YacineSot/sg13cmos5l_yacinesot_ip__diff_opamp_cmfb/docs/README.md

## document file: 
[View PDF Document](docs/circuit-blocks-documentation.pdf)
