YacineSot/sg13cmos5l_yacinesot_ip__diff_opamp_cmfb/docs/circuit-blocks-documentation.pdf

# 1.5 V Fully Differential Class-AB Operational Amplifier

# Architectural & Subcircuit Documentation

# 1. Architectural Overview & Introduction

Block # | Subcircuit / Module Name | Primary Architectural Role
Block 1 | ota_cmfb_top_tb | Top-Level Multi-Mode SPICE Testbench Schematic
Block 2 | ota_cmfb_top | Top-Level Structural Integration, CMFB Sensing & ESD/Antenna Guarding
Block 3 | ota_cmfb_core | 5-Transistor PMOS Differential Input Core Stage & Output Stage Wrapper
Block 4 | ota_cmfb_core_push_pull_output_stage | Monticelli Class-AB Output Driver with gmp >> gmn Decoupling
Block 5 | ota_cmfb_fbota | Continuous-Time Common-Mode Feedback (CT-CMFB) Error Amplifier
Block 6 | ac_diff_probe | Differential AC Probe for Open-Loop Gain and Phase Measurement
Block 7 | ac_probe | Single-Ended AC Loop-Breaking Probe

# 2. Block 1: Top-Level Testbench (ota_cmfb_top_tb)

# Figure 1: Top-Level Testbench Structured Schematic Diagram (ota_cmfb_top_tb)

Functional Description & Role: Executes all required DC, AC, transient, noise, PSRR, CMRR, and statistical Monte Carlo mismatch simulations for the operational amplifier macro.

# Key Technical Specifications:

- Modular Simulation Control: Toggle individual simulation blocks (OP_SIM, DC_SIM, DC_LOOP_SIM,

# AC_SIM, AC_LOOP_SIM, TRAN_SIM, NOISE_SIM, PSRR_SIM, CMRR_SIM, MC_SIM) on or off and click

SimulateNGSPICE or SimulatePARALLEL to launch.
- Unified Verification Environment: Consolidates nominal corner verification (mos_tt, moscap_tt, res_typ, dio_tt) and 100-run Monte Carlo mismatch analysis (mos_tt_mismatch) within a single testbench interface with default load conditions CL = 0.1 pF and RL = 100 kΩ.

VDD

Vcm
Vinn

Vinp

Ibias

Voutn
Voutp

VSS

EN

NETLIST
VSS VSS 0 0
VDD VDD VDD_AC 1.5
VDD_AC VDD_AC VSS 0 AC 0
VEN EN VSS 1.5
Vcm Vcm VSS {vcm}
Ibias VDD Ibias 2.5u

OP_SIM
.control
op
let ro_n = voutn/i(vmeas2) let ro_p = voutp/i(vmeas3) print ro_n ro_p
write ota_cmfb_top_tb.raw
.endc

Libs_Ngspice

.lib cornerMOSlv.lib mos_tt .lib cornerMOShv.lib mos_tt .lib cornerMOSCAP.lib moscap_tt .lib cornerCAP.lib cap_typ .lib cornerRES.lib res_typ .lib cornerDIO.lib dio_tt

SIM=ngspice

OP annotate

AC_SIM
.control
ac dec 50 100 100G
let vout_diff = voutp-voutn let vin_diff = vinp-vinn
let diff_gain=vout_diff/vin_diff
let op_mag=db(diff_gain)
let op_ph = 180*cph(diff_gain)/pi + 180 let vcm_1 = (voutp+voutn)/2
let vcm_err = mag((vcm_1 - {vcm}))[0]
echo results_save_begin
meas ac dc_gain find op_mag when frequency=1000 meas ac gain_margin find op_mag when op_ph=0
meas ac phase_margin find op_ph when op_mag=0
meas ac bw_3db find frequency when op_mag=dc_gain-3 meas ac Gain_BW find frequency when op_mag=0 print vcm_err
echo results_save_end
plot op_mag op_ph
.endc

PARAMS
.option rshunt=1e9
.options method=gear
.param vcm=0.75 vcm_in=0.75 cl=0.1p vac=1 .save all
Vinp | Voutn
Vinn | Voutp

LOAD
CL1 Voutp 0 {cl}
CL2 Voutn 0 {cl}
RL1 Voutp 0 100k
RL2 Voutn 0 100k

xprobe1
vcm={vcm_in}
vac={vac}
IN | OUT

SAVE
.include ota_cmfb_top_tb.save

Vmeas2 Vmeas3

Vmeas4 Vmeas5

TRAN_SIM
Vinp Vinp 0 sin({vcm_in} 100u 10k) Vinn Vinn 0 sin({vcm_in} -100u 10k) .control
tran 100n 1m
plot Vinp Vinn Voutp Voutn
plot Vinp-Vinn Voutp-Voutn .endc
SimulateNGSPICE

AC_LOOP_SIM
.control
set gain_pcmd = ""
set ph_pcmd = ""
set ph_mrg = ""
set vcm_param = vcm_in
set curplot = new
compose vcm_vec start=0 stop=1.5 step=0.1 foreach vcm_val $&vcm_vec
reset
alterparam $vcm_param =$vcm_val ac dec 50 100 100G
let cur_vcm=$vcm_val
let vout_diff = voutp-voutn
let vin_diff = vinp-vinn
let diff_gain=vout_diff/vin_diff
let op_mag=db(diff_gain)
let op_ph = 180*cph(-diff_gain)/pi
set gain_pcmd = " $gain_pcmd {$curplot}.op_mag " set ph_pcmd = " $ph_pcmd {$curplot}.op_ph "
meas ac phase_margin find op_ph when op_mag=0
if $&phase_margin
set ph_mrg = " $ph_mrg {$curplot}.phase_margin " end
set ph_mrg = " $ph_mrg {$curplot}.cur_vcm "
end
//set nolegend
plot $gain_pcmd
plot $ph_pcmd
print $ph_mrg
.endc

MC_SETTINGS
**nr_workers=1
**nr_mc_sims=100
**results_plot_begin
**dc_gain
**gain_margin
**phase_margin
**bw_3db
**Gain_BW
**vcm_err
**results_plot_end

SimulatePARALLEL

MC_SIM

Vinp Vinp 0 {vcm_in + 100u} Vinn Vinn 0 {vcm_in - 100u} .control
set num_threads 8
op
run
let vcm_err = vcm-vcm_calc
let gain = (voutp-voutn)/(vinp-vinn) echo results_save_begin
print vcm_calc vcm_err gain
echo results_save_end
.endc

SIM=ngspice

Libs_MISMATCH

.lib cornerMOSlv.lib mos_tt_mismatch .lib cornerMOShv.lib mos_tt_mismatch .lib cornerMOSCAP.lib moscap_tt .lib cornerCAP.lib cap_typ
.lib cornerRES.lib res_typ
.lib cornerDIO.lib dio_tt

SIM=ngspice

Vmeas6
Voutp

Vinn

DC_LOOP_SIM
Vt_p Vt_p 0 0
Vt_n Vt_n 0 0
.control
set curplot = new
set plt_voutp = ""
set plt_voutn = ""
set plt_vt_p = ""
set plt_vdiff = ""
set plt_voutpn = ""
compose vcm_vec start=0 stop=1.5 step=0.1 foreach vcm_val $&vcm_vec
alterparam vcm = $vcm_val
reset
dc Vt_p 0 1.5 0.01
let Vout = v(Voutp) - v(Voutn)
set plt_voutp = " {$plt_voutp} {$curplot}.voutp "
set plt_voutn = " {$plt_voutn} {$curplot}.voutn "
set plt_vdiff = " {$plt_vdiff} {$curplot}.vout "
set plt_voutpn = " {$plt_voutpn} {$curplot}.voutp {$curplot}.voutn " end
plot $plt_voutpn
plot $plt_vdiff
.endc

DC_SIM
Vt_p Vt_p 0 0
Vt_n Vt_n 0 0
.control
dc Vt_p 0 1.5 0.01
let Vout = Voutp - Voutn
plot Vt_p Voutp Voutn
plot Vt_p Vout
.endc

2

1 R1

500k
m=1

2

1 R2

500k

m=1

Vmeas7

Voutn

Vinp

2

1 R3

500k

m=1

2

1 R4

500k

m=1

Vt_n Vt_p

Vcm | Vo+ Vo-

XDIFF_AMP1

V+ VDD

V-

Ib

EN

VSS

ota_cmfb_top

NOISE_SIM
Vinp Vinp 0 sin({vcm_in} 100u 10k) Vinn Vinn 0 sin({vcm_in} -100u 10k) .control
tran 100n 1m
plot Vinp Vinn Voutp Voutn
plot Vinp-Vinn Voutp-Voutn .endc

PSRR_SIM
.control
save all
* 1. Measure Differential Gain (Adiff)
* Apply 1V AC across the differential inputs, 0V AC on VDD alterparam vac=1
reset
alter VDD_AC acmag=0
ac dec 10 100 100G
* Store the result in a custom vector let Adiff_db = db(voutp - voutn) alterparam vac=0
reset
* 2. Measure Power Supply Gain (Add)
* Turn off input AC, apply 1V AC on VDD alter VDD_AC acmag=1
ac dec 10 100 100G
* Store the supply gain result
let Add_db = db(voutp - voutn)
* 3. Calculate and Plot True PSRR * PSRR(dB) = Adiff(dB) - Add(dB) let diff_gain = ac1.Adiff_db
let supply_gain = Add_db
let psrr_db = ac1.Adiff_db - Add_db
plot psrr_db ylabel 'PSRR (dB) = A_diff - A_dd' plot supply_gain ylabel 'A_dd (dB)'
plot diff_gain ylabel 'A_diff (dB)'
.endc

CMRR_SIM
.control
save all
ac dec 10 100 100G
let acm_db = db((voutp + voutn)/2) let adiff_db = db(voutp - voutn) let cmrr_db = adiff_db - acm_db
plot acm_db ylabel 'A_CM (dB)'
plot adiff_db ylabel 'A_diff (dB)'
plot cmrr_db ylabel 'CMRR (dB) = A_diff - A_CM' .endc

SPICE SIMULATION

AC ANALYSIS PROBE

CORE OPAMP

MONTE CARLO PYTHON

DC ANALYSIS SINGLE TO DIFF

# 3. Block 2: Top-Level Integration (ota_cmfb_top)

# Figure 2: Top-Level Operational Amplifier Structural Schematic Diagram (ota_cmfb_top)

Functional Description & Role: Integrates the core amplifier (xopamp1), continuous-time CMFB error amplifier (xota1), resistive common-mode sensing divider (R1, R2), layout dummy devices, and global ESD/antenna protection into a single macro pinout.

# Key Technical Specifications & Component Parameters:

- Master Supply Rails: VDD = 1.5 V, VSS = 0.0 V.
- Control & Reference Inputs: Vinp, Vinn, Vcm (output common-mode target range: 0.3 V to 1.1 V), EN (enable), Ibias (2.5 µA reference current).
- Common-Mode Sense Network: Matched resistive divider (R1 = R2, W/L = 0.5 µm / 10.0 µm, m = 1) using the high-resistivity polysilicon resistor model (rhigh) to sense the output common-mode voltage Vcm,calc = (Voutp + Voutn) / 2, sized for optimal matching and low thermal noise.
- Differential Outputs: Voutp, Voutn (1.2 Vpp differential swing).
- Antenna Protection Circuitry: Reverse-biased antenna clamp diodes D1 (dantenna, W = 0.78 µm, L = 0.78 µm) and D2 (dpantenna, W = 1.05 µm, L = 1.34 µm) on the EN net.
- Additional ESD Clamping: Because this circuit is integrated into a multi-project wafer (MPW) where the PDK's analog I/O pads clamp input voltages to Vhigh = 3.3 V and VSS, dedicated secondary ESD clamps (XPCLAMP1–XPCLAMP3, sg13cmos5l_ESD_Protection) are added on Voutp, Voutn, and Vcm to clamp voltages locally to the 1.5 V core supply rail (VDD_BUS).
Vcm | Vo+ Vo-

## xopamp1

## V+ VDD

V-

Ib

EN

## VSS

## ota_cmfb_core

Vb

# VDD

# Vcm_reg Vinn

# Vinp

# Ibias

# Voutn Voutp

# VSS

EN

# Vcm

# Vcm_calc

## xota1

## V+ VDD

V-

Ib

EN

## VSS

## ota_cmfb_fbota

# VDD

EN

# Vbias

# VSS

# Vcm_reg

Voutp | Voutn
M7

G

## sg13_lv_nmos

m=2

ng=1

l=0.5u

w=0.25u

S

D
B

?

# VSS

## w/l = 0.5e-6 / 1e-6*10

## rhigh

R1

R= ( 1.6e-4 / 0.5e-6 + 1360.0 * ( (0 + 1)* 1e-6*10 + ( 1.081*( 0.5e-6 - 0.04e-6 ) + 0.18e-6 )*0 ) / ( 0.5e-6 - 0.04e-6 ) ) / 1

b=0
m=1

## w/l = 0.5e-6 / 1e-6*10 VSS

## rhigh

R2

b=0
m=1

VSS
M1

G

## sg13_lv_nmos

m=10

ng=1

l=0.5u

w=3.2u

S

D
B

?

# VSS

M2

G

## sg13_lv_pmos

m=100

ng=1

l=0.5u

w=1.985u

D

S
B
?

# VDD

D1

## dantenna

d0

d1
l=0.78u
w=0.78u

D2

## dpantenna

d0

d1
l=1.34u
w=1.05u

# VDD

# VSS

# Vbias

# Vbias

pad

VDD

SUB

XPCLAMP1 sg13cmos5l_ESD_Protection

pad

VDD

SUB

XPCLAMP2 sg13cmos5l_ESD_Protection

pad

VDD

SUB

XPCLAMP3 | sg13cmos5l_ESD_Protection
VSS | VSS

# VSS

VDD_BUS | VDD_BUS

# VDD_BUS

| s1 .include /run/media/yacinesot/My_Files/XschemDesigns/designs/Chipalooza2/schema/sg13cmos5l_ESD_Protection/sg13cmos5l_ESD_Protection.spice
FEEDBACK LOOP R= ( 1.6e-4 / 0.5e-6 + 1360.0 * ( (0 + 1)* 1e-6*10 + ( 1.081*( 0.5e-6 - 0.04e-6 ) + 0.18e-6 )*0 ) / ( 0.5e-6 - 0.04e-6 ) ) / 1 | XCLAMP_LVS_NETLIST Dummies EN
Voutp | Voutn

# Vcm

s2

# VDD_BUS VDD_BUS 0 1.5

# CORE OPAMP

# 4. Block 3: Differential Input Core Stage (ota_cmfb_core)

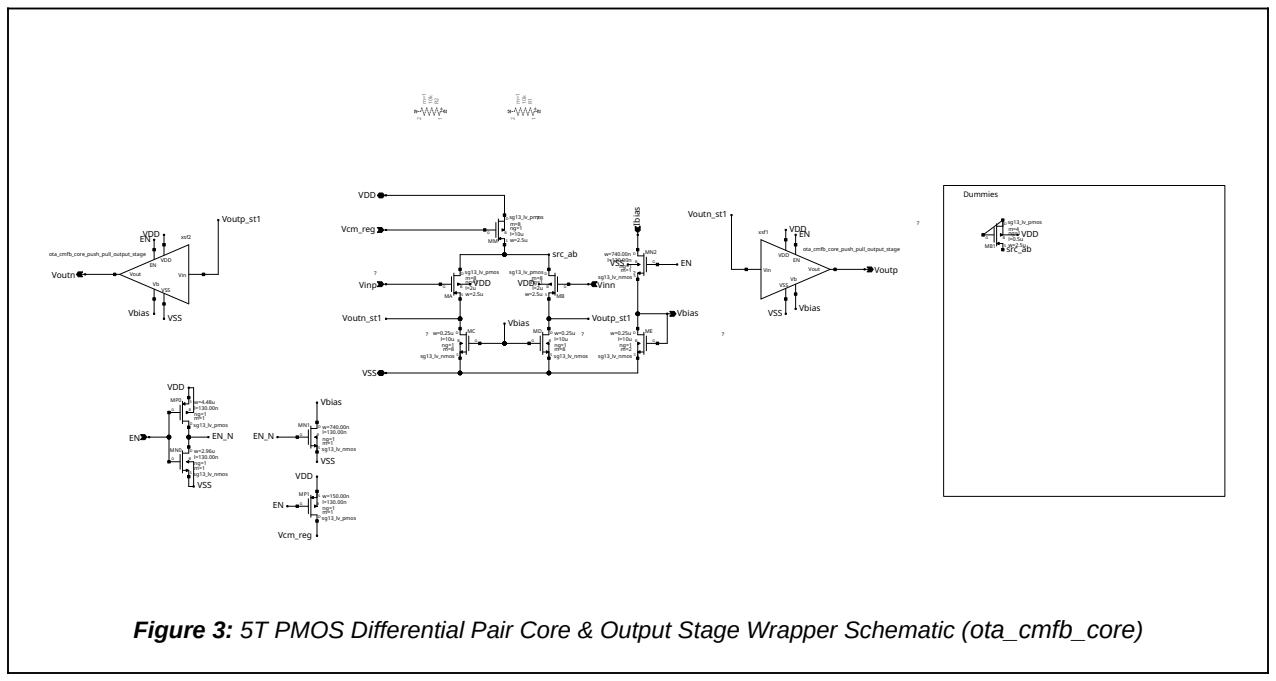
[picture p5: figure]
sg13_lv_nmos; sg13_lv_pmos m=8 ng=1 l=2u w=2.5u; sg13_lv_pmos m=8 ng=1 l=10u w=2.5u; Voutn; Voutp; VDD; VSS; Vinp; Ibias; Vinn; Vcm_reg; Vbias; Voutp_st1; VSS Vbias; Voutn_st1; Vout; xsf1; Vin; ota_cmfb_core_push_pull_output_stage; xsf2; sg13_lv_pmos; sg13_lv_pmos m=4 ng=1 l=0.5u w=2.5u; src_ab src_ab; B VSS; Dummies

# Figure 3: 5T PMOS Differential Pair Core & Output Stage Wrapper Schematic (ota_cmfb_core)

Functional Description & Role: Provides primary input transconductance (gm1) and first-stage voltage gain (Av1) with ultra-low flicker (1/f) noise, driving the dual Class-AB push-pull output stage instances (xsf1, xsf2).

# Key Technical Specifications & Transistor Parameters:

- Input Drivers (MA / MB): PMOS differential pair (sg13_lv_pmos) sized W/L = 2.5 µm / 2.0 µm (m = 8) to suppress 1/f flicker noise and maximize intrinsic device gain (gm · rout).
- Active Loads (MC / MD): Long-channel NMOS active loads (sg13_lv_nmos, W/L = 0.25 µm / 10.0 µm, m = 8) biased via diode-connected reference transistor ME (W/L = 0.25 µm / 10.0 µm, m = 2) to provide high first-stage output impedance.
- Tail Bias Generator (MM): PMOS current source (sg13_lv_pmos, W/L = 2.5 µm / 10.0 µm, m = 8) controlled directly by the CMFB error signal (Vcm_reg).
- First-Stage Output Nodes: Voutn_st1 and Voutp_st1 driving the push-pull output stage instances (xsf1, xsf2).

# 5. Block 4: Monticelli Class-AB Output Stage

# (ota_cmfb_core_push_pull_output_stage)

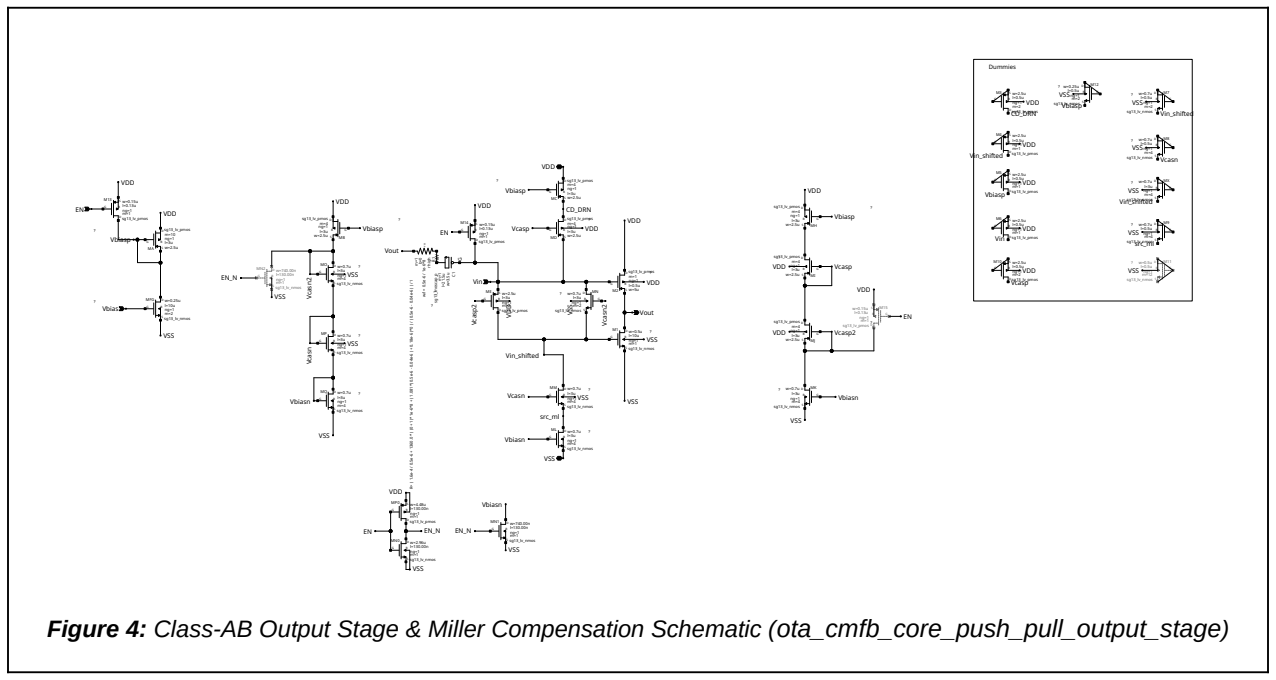
[picture p6: figure]
sg13_lv_nmos; sg13_lv_pmos m=1 ng=1 l=0.5u w=5u; VDD; VSS; Vbias; Vin; Vout; Vin_shifted; sg13_lv_pmos m=4 ng=1 l=3u w=2.5u; Vbiasn; Vbiasp; Vcasn2; Vcasp2; sg13_lv_pmos; Vcasp; Vcasn; rhigh; sg13_moscap_p; MFG; sg13_lv_pmos m=10 ng=1 l=3u w=2.5u; CD_DRN; ? VSS; ? VSS Vin_shifted; src_ml; ? VSS src_ml; VDD Vcasp; ? VSS Vbiasp; Dummies

Figure 4: Class-AB Output Stage & Miller Compensation Schematic (ota_cmfb_core_push_pull_output_stage)

Functional Description & Role: A fully self-contained, cascoded Monticelli Class-AB push-pull output buffer providing dynamic current drive, wide rail-to-rail output swing (0.1V to 1.3 V), and second-stage voltage gain. The block integrates its own internal cascode and translinear mesh bias generators derived directly from the 2.5 μ A master reference (Vbias), along with dedicated active-high enable (EN) tie-off switches on every floating bias and signal node.

# Key Technical Specifications & Transistor Parameters:

# - Primary Reference Mirror (MFG / MA): MFG (sg13_lv_nmos, W / L=0.25 μm / 10.0 μm, m=2

) is unit-matched to the first-stage bias reference (ME) to accurately copy the 2.5 μ A reference current, driving diode-connected PMOS load MA (sg13_lv_pmos, W / L=2.5 μm / 3.0 μm, m=10) to establish the master PMOS bias rail (Vbiasp).

- Cascoded Current-Source Loads (MC, MD & ML, MM): In textbook Monticelli topologies, the floating Class-AB control mesh is biased by ideal current sources; here, high-impedance cascoded current sources are implemented via MC (main PMOS current source) cascoded by MD (both W / L=2.5 μm / 3.0 μm, m= 4) on the upper branch, and ML (main NMOS current

source) cascoded by MM (both W / L=0.7 μm / 3.0 μm, m= 4) on the lower branch.
- Floating Class-AB Mesh / Level Shifters (ME & MN): Head-to-tail translinear mesh transistors ME (sg13_lv_pmos, W / L=2.5 μm / 3.0 μm, m=2, biased by Vcasp2) and MN (sg13_lv_nmos, W / L=0.7 μm / 3.0 μm, m=2, biased by Vcasn2) act as floating voltage level shifters between

# the Vin (PMOS gate) and Vin_shifted (NMOS gate) nodes, regulating quiescent Class-AB

current while providing dynamic push-pull drive.

# - Integrated Cascode & Mesh Bias Generators: Two multi-device replica stacks generate all required cascode and mesh bias potentials locally:PMOS Bias Branch (MH, MI, MJ —

R= ( 1.6e-4 / 0.5e-6 + 1360.0 * ( (0 + 1)* 1e-6*8 + ( 1.081*( 0.5e-6 - 0.04e-6 ) + 0.18e-6 )*0 ) / ( 0.5e-6 - 0.04e-6 ) ) / 1

# W / L=2.5 μm / 3.0 μm, m= 4): Establishes Vcasp and Vcasp2, terminated at the bottom by

NMOS diode load MK (W / L=0.7 μm / 3.0 μm, m= 4) to generate Vbiasn.

# - NMOS Bias Branch (MB, MO, MP, MQ): Mirrors the PMOS current via MB (

W / L=2.5 μm / 3.0 μm, m= 4) into the NMOS stack (MO, MP, MQ — W / L=0.7 μm / 3.0 μm,

# m= 4) to generate Vcasn2 and Vcasn. Pairing MK and MQ with MH and MC enforces strict

current matching across all branches.

# - Asymmetric Output Drivers (M2 & M1) & Pole-Zero Positioning: PMOS driver M2 (

W / L=5.0 μm / 0.5 μm, m=1) and long-channel NMOS driver M1 (W / L=0.5 μm / 10.0 μm,

# m=1) establish gmp≫gmn asymmetry, pushing the NMOS right-half-plane (RHP) zero well

above the target unity-gain bandwidth (GBW = 40 – 50MHz).
- Miller Compensation Network (C1 & R1): PMOS accumulation capacitor CC (C1,

# sg13_moscap_p, W =3.5 μm , L=21.5 μm ,m=1) in series with nulling resistor RC =23.97 k Ω

(R1, rhigh, W / L=0.5 μm / 8.0 μm ,m=1) guarantees a 60 – 65 phase margin.

# - Full Floating-Node Enable / Power-Down Protection: An active-high enable (EN) inverter (MP0 / MN0) generates EN_N to drive dedicated pull-up (M13, M14, M15 to VDD) and pull-

down (MN1, MN2 to VSS) switches on every internal bias and floating node (Vbiasp, Vbiasn, Vcasp2, Vcasn2, Vin), eliminating floating-gate leakage and ensuring deterministic zero-current shutdown when EN = 0.

# 6. Block 5: Continuous-Time CMFB Amplifier (ota_cmfb_fbota)

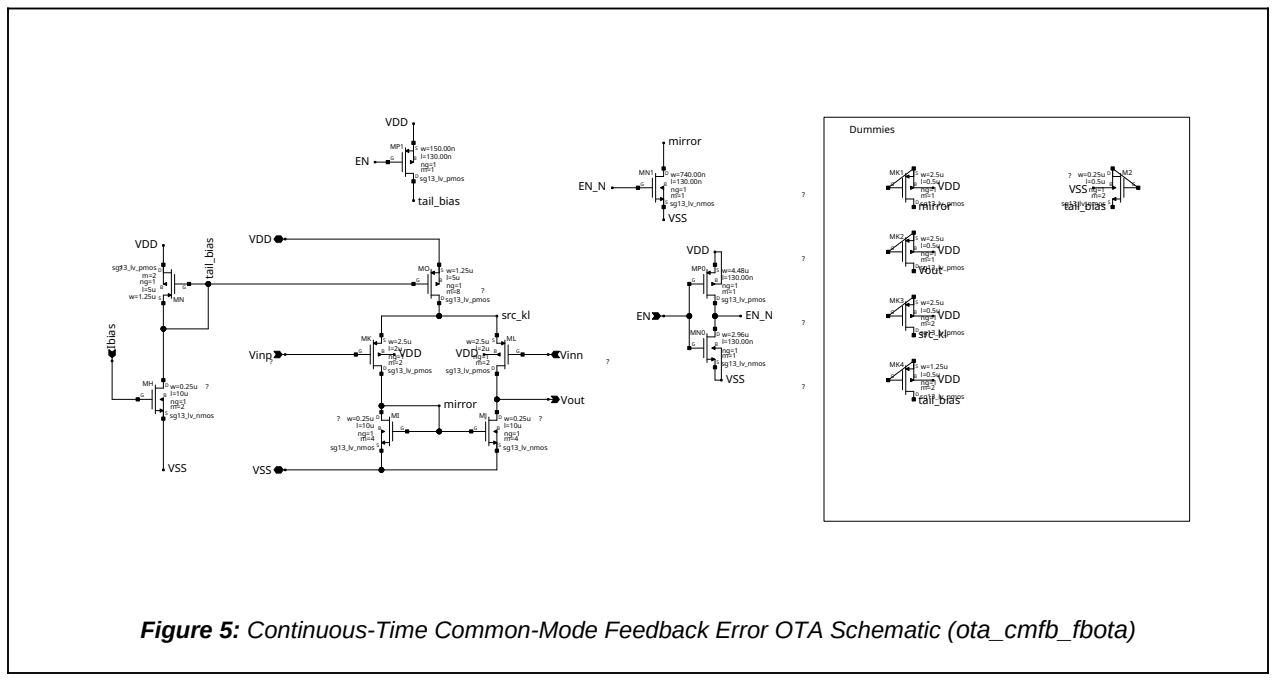
[picture p7: figure]
sg13_lv_nmos; sg13_lv_pmos; Vout; VDD; VSS; Vinp; Ibias; Vinn; mirror; sg13_lv_pmos m=2 ng=1 l=5u w=1.25u; tail_bias; ? VSS tail_bias; VDD mirror; VDD Vout; src_kl; VDD src_kl; VDD tail_bias; Dummies

# Figure 5: Continuous-Time Common-Mode Feedback Error OTA Schematic (ota_cmfb_fbota)

Functional Description & Role: Senses the output common-mode voltage error and regulates the main core tail bias (Vcm_reg) to lock Vcm,out at the user's reference input Vcm.

# Key Technical Specifications & Transistor Parameters:

- Error Input Pair (MK / ML): PMOS differential input pair (sg13_lv_pmos, W/L = 2.5 µm / 2.0 µm, m = 2) comparing the sensed common-mode voltage (Vcm_calc) against the Vcm reference.
- Active Mirror Load (MI / MJ): Long-channel NMOS current mirror load (sg13_lv_nmos, W/L = 0.25 µm / 10.0 µm, m = 4) providing the single-ended regulation output Vout (Vcm_reg).
- Tail Current Mirror (MO / MN / MH): PMOS tail current source MO (W/L = 1.25 µm / 5.0 µm, m = 8) mirrored from diode-connected MN (m = 2) and reference sink MH (W/L = 0.25 µm / 10.0 µm, m = 2).

# - Low-Frequency Common-Mode Rejection: Provides >97.5 dB CMRR at low frequencies under

statistical Monte Carlo mismatch.

# 7. Block 6: Differential AC Probe (ac_diff_probe)

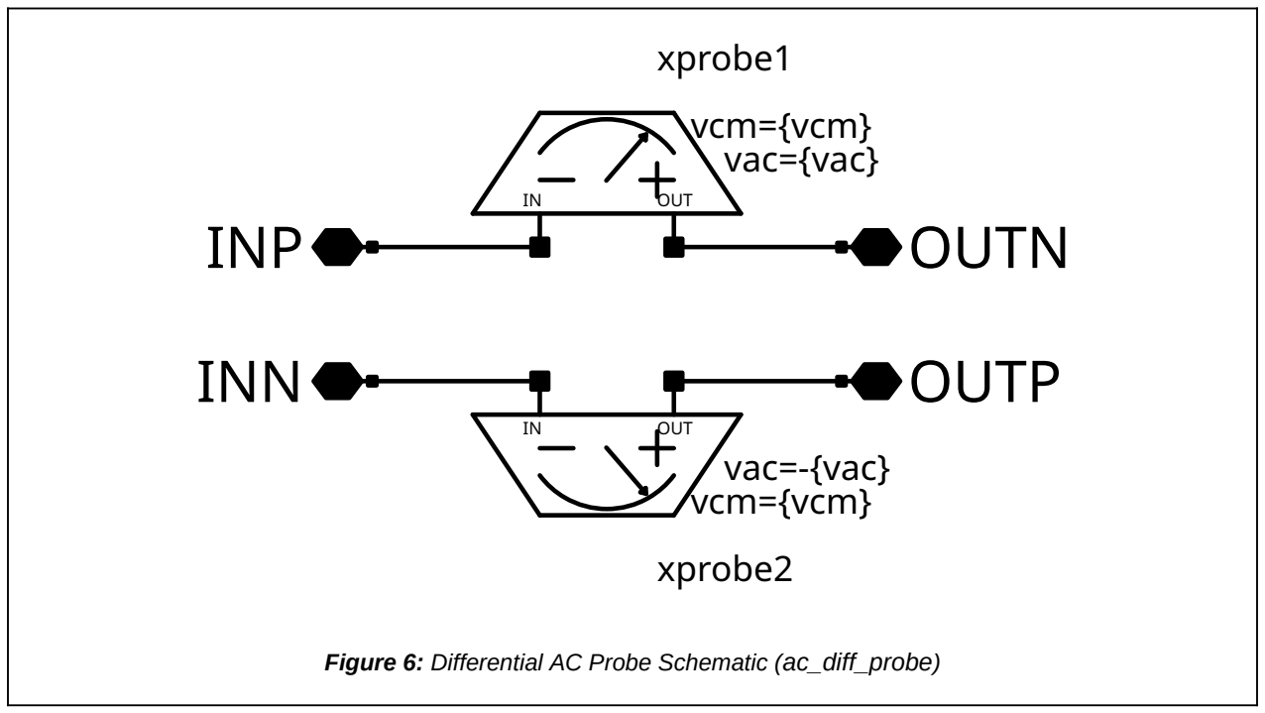
[picture p8: figure]
xprobe1 vcm={vcm} vac={vac}; OUT; xprobe2; vcm={vcm}; vac=-{vac}; INP; OUTN; INN; OUTP

# Figure 6: Differential AC Probe Schematic (ac_diff_probe)

Functional Description & Role: Closes the operational amplifier feedback loop at DC while blocking AC feedback and injecting a differential AC stimulus to measure open-loop gain and phase in a fully differential topology.

# Key Technical Specifications:

- Dual Single-Ended Probe Topology: Instantiates two matched single-ended AC probes (xprobe1 driven with vcm={vcm}, vac={vac} between INP and OUTN; xprobe2 driven with anti-phase vcm={vcm}, vac=-{vac} between INN and OUTP).

# 8. Block 7: Single-Ended AC Probe (ac_probe)

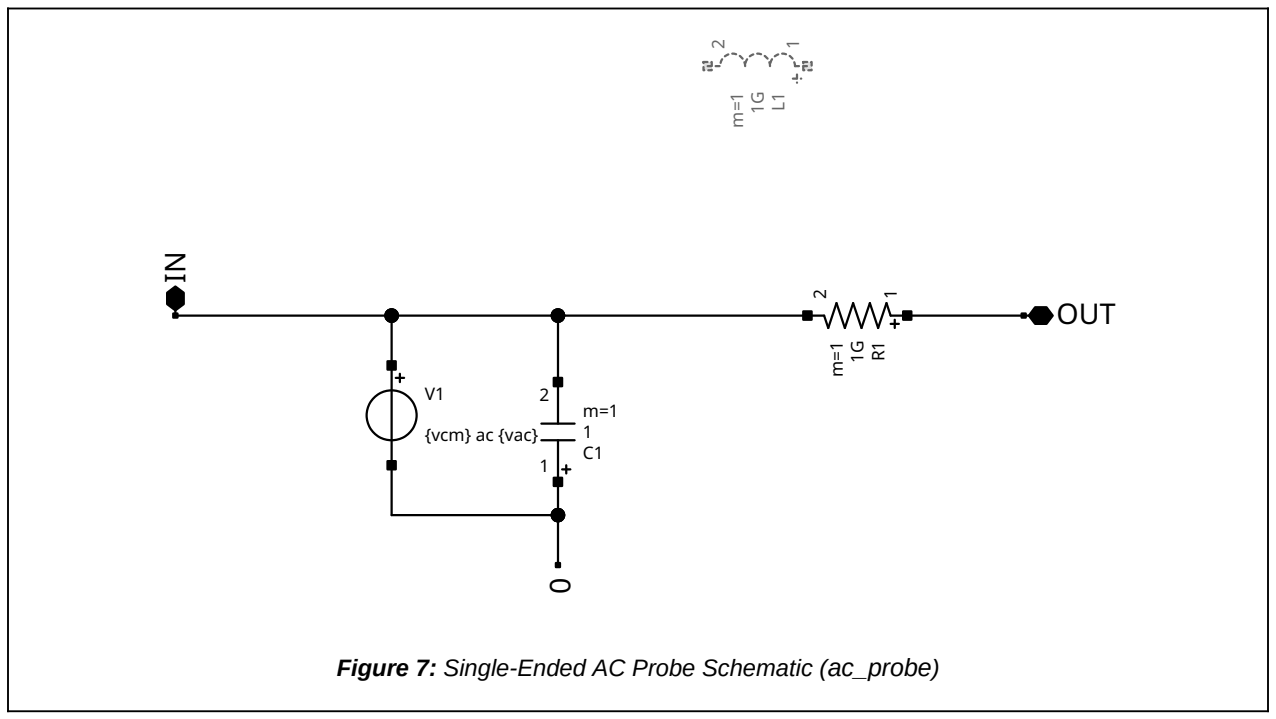
[picture p9: figure]
OUT; {vcm} ac {vac}

# Figure 7: Single-Ended AC Probe Schematic (ac_probe)

Functional Description & Role: Used as the core building block inside the differential AC probe (ac_diff_probe), and can also be used standalone in single-ended amplifier topologies to sense open-loop AC gain while maintaining DC operating-point feedback.

# Key Technical Specifications & Component Parameters:

- Large-RC Loop-Breaking Network: Combines a 1 GΩ feedback resistor (R1 = 1G, m = 1) between OUT and IN with a 1 F AC-shunt capacitor (C1 = 1, m = 1) and parameterized AC/DC voltage source V1 ({vcm} ac {vac}) to pass DC feedback while isolating the AC test signal.
