YacineSot/sg13cmos5l_yacinesot_ip__diff_opamp_cmfb/docs/schema.png

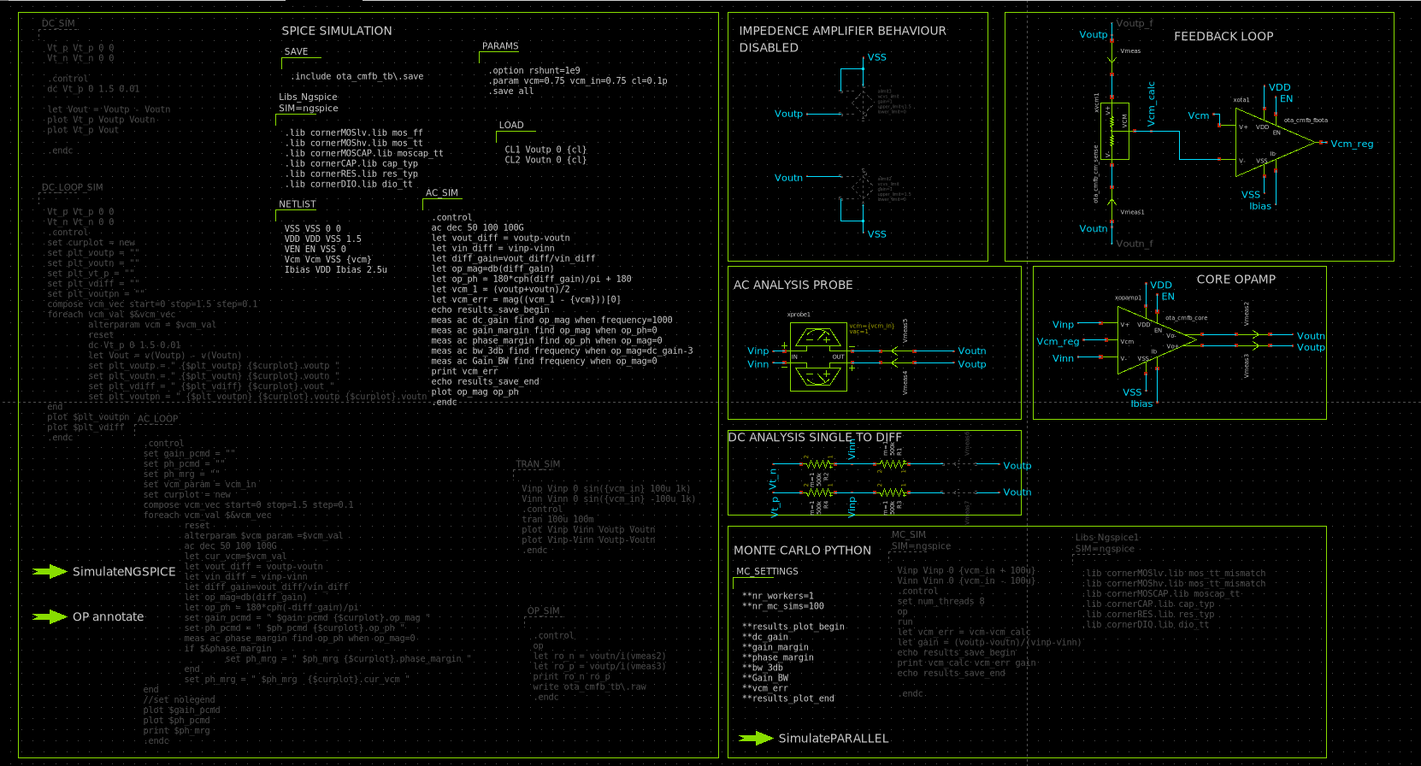
docs/schema.png
