YacineSot/sg13cmos5l_yacinesot_ip__diff_opamp_cmfb/schema/simulations/results/ota_cmfb_tb_mc_results.csv

dc_gain | gain_margin | phase_margin | bw_3db | gain_bw | vcm_err
47.1455 | -9.57211 | 61.4999 | 207017.0 | 51228600.0 | 0.002523438
44.8229 | -9.9307 | 64.5569 | 245086.0 | 48682000.0 | 0.01520574
46.3421 | -9.63473 | 61.8204 | 228009.0 | 51891500.0 | 0.01174944
44.6482 | -9.93246 | 64.7202 | 248711.0 | 48639400.0 | 0.01637787
45.2216 | -9.91678 | 64.055 | 237415.0 | 48814900.0 | 0.0139052
45.6358 | -9.85549 | 63.5306 | 231183.0 | 49072000.0 | 0.01107272
41.9859 | -10.4175 | 67.1973 | 297154.0 | 44809200.0 | 0.02031546
32.7754 | -11.1453 | 72.3986 | 599553.0 | 38848300.0 | 0.0267547
46.7651 | -9.63541 | 61.4848 | 215913.0 | 51095900.0 | 0.005474977
39.1572 | -10.6207 | 69.1689 | 368317.0 | 42753600.0 | 0.0227545
45.1221 | -9.88121 | 64.1517 | 238595.0 | 49022900.0 | 0.01398859
36.5019 | -10.8788 | 70.6845 | 449631.0 | 40771200.0 | 0.02492743
44.4751 | -10.0176 | 64.7135 | 252207.0 | 48106500.0 | 0.0158984
42.4171 | -10.3309 | 66.7388 | 291018.0 | 45870500.0 | 0.02128149
43.2979 | -10.2406 | 66.5331 | 264097.0 | 45690400.0 | 0.01660877
46.822 | -9.54805 | 61.7542 | 215506.0 | 51840100.0 | 0.006786055
38.7217 | -10.7533 | 69.6028 | 376020.0 | 41921500.0 | 0.0237199
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
