YacineSot/sg13cmos5l_yacinesot_ip__diff_opamp_cmfb/schema/simulations/results/ota_cmfb_top_pex_tb_mc_cmrr.csv

cmrr_100 | cmrr_ugf
81.7914 | 9.10245
118.557 | 41.8834
99.7083 | 23.2925
108.935 | 27.7405
100.209 | 22.5916
84.0874 | 10.7756
107.458 | 26.2868
91.2335 | 15.2166
114.246 | 36.1042
78.0669 | 8.22965
111.632 | 39.9823
92.9463 | 16.6244
96.6593 | 18.3554
103.222 | 20.8659
91.3873 | 14.898
81.0615 | 9.07857
108.548 | 32.0787
97.4844 | 20.8995
106.529 | 26.9544
88.9524 | 12.5535
116.95 | 42.4238
95.422 | 18.1458
101.889 | 20.8874
110.735 | 34.7259
87.0277 | 11.8912
117.549 | 41.6751
85.1861 | 10.3839
80.7102 | 8.80754
102.573 | 24.9306
113.291 | 34.5285
94.5806 | 17.0903
99.8839 | 20.523
91.9975 | 16.8292
98.9371 | 19.4028
109.386 | 26.2715
91.4747 | 14.9583
96.3318 | 18.9537
86.0406 | 11.2674
94.1537 | 17.8168
90.1518 | 13.5032
95.8139 | 19.5823
95.8508 | 18.1555
93.7551 | 16.0331
94.7409 | 17.8068
99.6166 | 21.642
92.3017 | 15.2425
89.433 | 13.3446
87.5392 | 11.6693
97.6259 | 19.7249
89.256 | 13.1899
94.128 | 15.9575
91.0874 | 13.9212
80.9604 | 8.75672
89.1402 | 13.7353
100.015 | 21.8852
86.6697 | 12.0925
82.4525 | 9.9779
98.5801 | 20.1779
92.7148 | 15.2764
93.3225 | 16.4813
96.9347 | 20.1372
97.9545 | 20.3021
117.853 | 43.004
90.7896 | 14.098
89.5209 | 13.3286
86.1333 | 11.391
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
