YacineSot/sg13cmos5l_yacinesot_ip__diff_opamp_cmfb/schema/simulations/results/ota_cmfb_top_pex_tb_mc_noise.csv

noise_1 | noise_10 | noise_100 | noise_1k | noise_10k | noise_100k | noise_1meg | inoise_total
6.37764e-06 | 2.016932e-06 | 6.382673e-07 | 2.03279e-07 | 6.868025e-08 | 3.293664e-08 | 2.869544e-08 | 1.952248e-05
6.373428e-06 | 2.015601e-06 | 6.378513e-07 | 2.031618e-07 | 6.868583e-08 | 3.307218e-08 | 2.892062e-08 | 1.95113e-05
6.397274e-06 | 2.023143e-06 | 6.40239e-07 | 2.039264e-07 | 6.895496e-08 | 3.311808e-08 | 2.877224e-08 | 1.958481e-05
6.410063e-06 | 2.027188e-06 | 6.415179e-07 | 2.043284e-07 | 6.907498e-08 | 3.316583e-08 | 2.889141e-08 | 1.962317e-05
6.406275e-06 | 2.02599e-06 | 6.41141e-07 | 2.042157e-07 | 6.905842e-08 | 3.318764e-08 | 2.882713e-08 | 1.961247e-05
6.408208e-06 | 2.026602e-06 | 6.413367e-07 | 2.042856e-07 | 6.910382e-08 | 3.322351e-08 | 2.88464e-08 | 1.961936e-05
6.41498e-06 | 2.028743e-06 | 6.4201e-07 | 2.044861e-07 | 6.913119e-08 | 3.319481e-08 | 2.88613e-08 | 1.963837e-05
6.418417e-06 | 2.029829e-06 | 6.423524e-07 | 2.045915e-07 | 6.915595e-08 | 3.315436e-08 | 2.876297e-08 | 1.964852e-05
6.37641e-06 | 2.016543e-06 | 6.381468e-07 | 2.03248e-07 | 6.869072e-08 | 3.294669e-08 | 2.859339e-08 | 1.951955e-05
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
