YacineSot/sg13cmos5l_yacinesot_ip__diff_opamp_cmfb/schema/simulations/results/ota_cmfb_top_pex_tb_mc_psrr.csv

psrr_100 | psrr_ugf
58.1249 | 14.7883
57.1335 | 13.3678
59.8133 | 18.4378
60.1627 | 16.7432
76.0866 | 28.8242
56.7827 | 12.2603
53.5812 | 10.6886
61.6259 | 16.7517
55.8288 | 13.5611
59.2358 | 15.7044
88.7618 | 35.1159
79.4503 | 35.9983
45.7652 | 7.39977
57.0305 | 18.1458
59.298 | 15.6044
72.1934 | 31.3225
58.996 | 24.887
55.1895 | 21.0139
55.6049 | 14.136
59.0175 | 14.9096
51.4366 | 10.9887
64.2497 | 21.3751
54.7188 | 11.2002
53.9948 | 10.3968
73.1389 | 27.4356
51.7979 | 10.9114
54.9503 | 10.6112
58.6731 | 16.1973
68.196 | 25.0019
61.9792 | 18.9896
63.7994 | 20.9468
48.4644 | 5.8941
53.7845 | 13.4578
54.1425 | 16.3073
53.2388 | 9.11531
58.8 | 16.0313
57.3463 | 17.1784
58.1244 | 13.796
54.0794 | 14.5264
69.5491 | 32.4788
77.5079 | 28.3036
55.8905 | 11.3108
55.9033 | 14.2218
61.2443 | 17.0912
46.6683 | 4.18193
57.5559 | 14.1437
70.2096 | 25.6923
51.475 | 5.96283
65.2174 | 21.6038
71.559 | 30.0737
53.8099 | 10.1562
61.205 | 19.9796
56.2822 | 12.4094
54.931 | 10.8354
59.4964 | 16.2495
56.226 | 17.8955
53.0407 | 7.83529
59.0775 | 16.3715
58.0854 | 16.8229
111.507 | 33.0247
58.0163 | 13.9324
60.813 | 17.18
56.798 | 15.8397
76.7819 | 40.5926
52.0816 | 6.70482
56.1026 | 14.7014
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
