YacineSot/sg13cmos5l_yacinesot_ip__diff_opamp_cmfb/schema/simulations/results/ota_cmfb_top_pex_tb_mc_results.csv

dc_gain | gain_margin | phase_margin | bw_3db | gain_bw | vcm_err
42.9257 | -7.7131 | 63.9481 | 249767.0 | 51909700.0 | 0.0165479
39.0585 | -7.76349 | 69.8738 | 349551.0 | 47251800.0 | 0.02053602
45.4611 | -6.85255 | 60.7831 | 199241.0 | 57362400.0 | 0.01087507
45.8623 | -7.40677 | 58.0737 | 196661.0 | 56767100.0 | 0.01018161
44.0155 | -7.62785 | 60.8849 | 231047.0 | 54769200.0 | 0.01566812
45.4801 | -6.91623 | 58.2316 | 202026.0 | 58964000.0 | 0.01159245
46.0408 | -7.04303 | 58.6688 | 192908.0 | 57819700.0 | 0.009289289
47.1319 | -6.65843 | 54.618 | 177252.0 | 62359500.0 | 0.005355808
47.3224 | -6.59543 | 55.0972 | 174038.0 | 62553500.0 | 0.003487363
46.6163 | -6.29118 | 54.8793 | 177668.0 | 65234500.0 | 0.009659106
46.6996 | -6.88999 | 55.799 | 183123.0 | 60195700.0 | 0.00696311
47.0481 | -7.09716 | 54.9807 | 180577.0 | 60373000.0 | 0.005957765
46.3429 | -6.7742 | 57.7843 | 188291.0 | 60059200.0 | 0.008454872
46.6349 | -6.77502 | 55.7509 | 184018.0 | 60935500.0 | 0.007291531
46.7444 | -7.00001 | 55.9483 | 186237.0 | 60382700.0 | 0.007660375
47.0701 | -6.48472 | 54.0023 | 179864.0 | 64219400.0 | 0.006039867
37.8002 | -8.61984 | 68.317 | 381556.0 | 44662100.0 | 0.02014335
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
