YacineSot/sg13cmos5l_yacinesot_ip__diff_opamp_cmfb/schema/simulations/results/ota_cmfb_top_tb_mc_results.csv

dc_gain | gain_margin | phase_margin | bw_3db | gain_bw | vcm_err
46.6201 | -4.75065 | 63.1752 | 216082.0 | 78864300.0 | 0.003282814
45.234 | -5.54867 | 64.3924 | 246107.0 | 72550100.0 | 0.01082155
45.6384 | -5.03631 | 64.9312 | 237689.0 | 75420600.0 | 0.009506908
46.6568 | -5.03296 | 63.0327 | 213107.0 | 77007600.0 | 0.003012813
41.0084 | -5.95927 | 73.5021 | 337318.0 | 57353500.0 | 0.01592211
29.0823 | -6.9297 | 81.5251 | 894176.0 | 40948500.0 | 0.02041766
30.3815 | -6.68028 | 81.1918 | 807097.0 | 41674200.0 | 0.01976359
45.1921 | -5.51568 | 65.6993 | 242025.0 | 70756400.0 | 0.01014312
28.2989 | -6.07123 | 84.807 | 942923.0 | 40587200.0 | 0.02232775
40.4082 | -6.25882 | 72.7368 | 357746.0 | 56916400.0 | 0.01839029
45.6581 | -4.92743 | 65.4883 | 234844.0 | 74993600.0 | 0.008958449
31.595 | -6.82094 | 80.0701 | 727853.0 | 42944800.0 | 0.02085175
46.2082 | -4.64309 | 63.8481 | 226026.0 | 79418000.0 | 0.006173965
46.3917 | -5.11821 | 62.713 | 221719.0 | 77150500.0 | 0.00534376
34.5163 | -7.23386 | 76.5467 | 582588.0 | 47290000.0 | 0.0197615
39.6885 | -6.56908 | 73.2133 | 373427.0 | 54391900.0 | 0.01853998
31.8339 | -5.83735 | 83.21 | 721540.0 | 43879000.0 | 0.02002658
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
