YacineSot/sg13cmos5l_yacinesot_ip__diff_opamp_cmfb/schema/sg13cmos5l_ESD_Protection/sg13cmos5l_ESD_Protection.spice

*.PININFO iovdd:B iovss:B pad:B
.subckt sg13cmos5l_ESD_Protection iovdd iovss pad
XI0 iovdd iovss pad sg13cmos5l_Clamp_P20N0D
XI2 pad iovdd iovss sg13cmos5l_DCPDiode
.ends

.subckt sg13cmos5l_Clamp_P20N0D iovdd iovss pad
XMP1 pad net2 iovdd iovdd sg13_hv_pmos w=133.2u l=600.0n ng=20 ad=2.531e-11 as=2.731e-11 pd=0.0001408 ps=0.0001547 m=1
XMP0 pad net2 iovdd iovdd sg13_hv_pmos w=133.2u l=600.0n ng=20 ad=2.531e-11 as=2.731e-11 pd=0.0001408 ps=0.0001547 m=1
XR0 net2 iovdd iovdd rppd R=6.768K l=12.9u w=500n
XR1 iovss sub! ptap1 R=9.826
.ends

.subckt sg13cmos5l_DCPDiode anode cathode guard
XD1 anode cathode dpantenna l=27.78u w=1.26u m=1
XD0 anode cathode dpantenna l=27.78u w=1.26u m=1
XR0 guard sub! ptap1 R=17.289
.ends
