YacineSot/sg13cmos5l_yacinesot_ip__diff_opamp_cmfb/schema/simulations/ota_cmfb_top.spice

** sch_path: /run/media/yacinesot/My_Files/XschemDesigns/designs/Chipalooza2/schema/ota_cmfb_top.sch
.subckt slot_5 Vcm VDD EN Vinp Voutn Voutp Vinn VSS Ibias
*.PININFO VDD:B Vinn:I Vinp:I Ibias:I Voutn:O Voutp:O VSS:B EN:I Vcm:I
xopamp1 VDD Vcm_reg Vinn Vinp Ibias Voutn Voutp VSS EN Vbias ota_cmfb_core
xota1 VDD EN Vbias Vcm_calc Vcm Vcm_reg VSS ota_cmfb_fbota
MM7 VSS VSS Vbias VSS sg13_lv_nmos w=0.25u l=0.5u ng=1 m=2
RR1 Voutn Vcm_calc 29.89k $SUB=VSS $[rhigh] w=0.5e-6 l=1e-6*10 b=0
RR2 Voutp Vcm_calc 29.89k $SUB=VSS $[rhigh] w=0.5e-6 l=1e-6*10 b=0
MM1 VSS VSS VSS VSS sg13_lv_nmos w=3.2u l=0.5u ng=1 m=10
MM2 VDD VDD VDD VDD sg13_lv_pmos w=1.985u l=0.5u ng=1 m=100
DD1 VSS EN dantenna l=0.78u w=0.78u
DD2 EN VDD dpantenna l=1.34u w=1.05u
XPCLAMP1 VDD_BUS VSS Voutp sg13cmos5l_ESD_Protection
XPCLAMP2 VDD_BUS VSS Voutn sg13cmos5l_ESD_Protection
XPCLAMP3 VDD_BUS VSS Vcm sg13cmos5l_ESD_Protection
**** begin user architecture code


*.PININFO iovdd:B iovss:B pad:B
.subckt sg13cmos5l_ESD_Protection iovdd iovss pad
XI0 iovdd iovss pad sg13cmos5l_Clamp_P20N0D
XI2 pad iovdd iovss sg13cmos5l_DCPDiode
.ends

.subckt sg13cmos5l_Clamp_P20N0D iovdd iovss pad
MP1 pad net2 iovdd iovdd sg13_hv_pmos w=133.2u l=600.0n ng=20 ad=2.531e-11 as=2.731e-11 pd=0.0001408 ps=0.0001547
MP0 pad net2 iovdd iovdd sg13_hv_pmos w=133.2u l=600.0n ng=20 ad=2.531e-11 as=2.731e-11 pd=0.0001408 ps=0.0001547
R0 net2 iovdd iovdd rppd R=6.768K l=12.9u w=500n
.ends

.subckt sg13cmos5l_DCPDiode anode cathode guard
D1 anode cathode dpantenna l=27.78u w=1.26u
D0 anode cathode dpantenna l=27.78u w=1.26u
.ends



**** end user architecture code
.ends

* expanding   symbol:  ota_cmfb_core/ota_cmfb_core.sym # of pins=10
** sym_path: /run/media/yacinesot/My_Files/XschemDesigns/designs/Chipalooza2/schema/ota_cmfb_core/ota_cmfb_core.sym
** sch_path: /run/media/yacinesot/My_Files/XschemDesigns/designs/Chipalooza2/schema/ota_cmfb_core/ota_cmfb_core.sch
.subckt ota_cmfb_core VDD Vcm_reg Vinn Vinp Ibias Voutn Voutp VSS EN Vbias
*.PININFO Voutn:O Voutp:O VDD:B VSS:B Vinp:I Ibias:I Vinn:I Vcm_reg:I EN:I Vbias:O
MMD Voutp_st1 Vbias VSS VSS sg13_lv_nmos w=0.25u l=10u ng=1 m=8
MMB src_ab Vinn Voutp_st1 VDD sg13_lv_pmos w=2.5u l=2u ng=1 m=8
MMC Voutn_st1 Vbias VSS VSS sg13_lv_nmos w=0.25u l=10u ng=1 m=8
MMA src_ab Vinp Voutn_st1 VDD sg13_lv_pmos w=2.5u l=2u ng=1 m=8
MMM VDD Vcm_reg src_ab VDD sg13_lv_pmos w=2.5u l=10u ng=1 m=8
MME Vbias Vbias VSS VSS sg13_lv_nmos w=0.25u l=10u ng=1 m=2
xsf1 VDD Voutn_st1 Voutp Vbias VSS EN ota_cmfb_core_push_pull_output_stage
xsf2 VDD Voutp_st1 Voutn Vbias VSS EN ota_cmfb_core_push_pull_output_stage
MMN0 EN_N EN VSS VSS sg13_lv_nmos w=2.96u l=130.00n ng=1
MMP0 EN_N EN VDD VDD sg13_lv_pmos w=4.48u l=130.00n ng=1
MMN1 Vbias EN_N VSS VSS sg13_lv_nmos w=740.00n l=130.00n ng=1
MMP1 Vcm_reg EN VDD VDD sg13_lv_pmos w=150.00n l=130.00n ng=1
MMB1 VDD VDD src_ab VDD sg13_lv_pmos w=2.5u l=0.5u ng=1 m=4
MMN2 Ibias EN Vbias VSS sg13_lv_nmos w=740.00n l=130.00n ng=1
.ends


* expanding   symbol:  ota_cmfb_fbota/ota_cmfb_fbota.sym # of pins=7
** sym_path: /run/media/yacinesot/My_Files/XschemDesigns/designs/Chipalooza2/schema/ota_cmfb_fbota/ota_cmfb_fbota.sym
** sch_path: /run/media/yacinesot/My_Files/XschemDesigns/designs/Chipalooza2/schema/ota_cmfb_fbota/ota_cmfb_fbota.sch
.subckt ota_cmfb_fbota VDD EN Ibias Vinn Vinp Vout VSS
*.PININFO Vout:O VDD:B VSS:B Vinp:I Ibias:I Vinn:I EN:I
MMJ Vout mirror VSS VSS sg13_lv_nmos w=0.25u l=10u ng=1 m=4
MML Vout Vinn src_kl VDD sg13_lv_pmos w=2.5u l=2u ng=1 m=2
MMI mirror mirror VSS VSS sg13_lv_nmos w=0.25u l=10u ng=1 m=4
MMK mirror Vinp src_kl VDD sg13_lv_pmos w=2.5u l=2u ng=1 m=2
MMO src_kl tail_bias VDD VDD sg13_lv_pmos w=1.25u l=5u ng=1 m=8
MMN VDD tail_bias tail_bias VDD sg13_lv_pmos w=1.25u l=5u ng=1 m=2
MMH tail_bias Ibias VSS VSS sg13_lv_nmos w=0.25u l=10u ng=1 m=2
MMN1 mirror EN_N VSS VSS sg13_lv_nmos w=740.00n l=130.00n ng=1
MM2 VSS VSS tail_bias VSS sg13_lv_nmos w=0.25u l=0.5u ng=1 m=2
MMK1 mirror VDD VDD VDD sg13_lv_pmos w=2.5u l=0.5u ng=1
MMK2 Vout VDD VDD VDD sg13_lv_pmos w=2.5u l=0.5u ng=1
MMK3 src_kl VDD VDD VDD sg13_lv_pmos w=2.5u l=0.5u ng=1 m=2
MMK4 tail_bias VDD VDD VDD sg13_lv_pmos w=1.25u l=0.5u ng=1 m=2
MMN0 EN_N EN VSS VSS sg13_lv_nmos w=2.96u l=130.00n ng=1
MMP0 EN_N EN VDD VDD sg13_lv_pmos w=4.48u l=130.00n ng=1
MMP1 tail_bias EN VDD VDD sg13_lv_pmos w=150.00n l=130.00n ng=1
.ends


* expanding   symbol:  ota_cmfb_core/ota_cmfb_core_push_pull_output_stage.sym # of pins=6
** sym_path: /run/media/yacinesot/My_Files/XschemDesigns/designs/Chipalooza2/schema/ota_cmfb_core/ota_cmfb_core_push_pull_output_stage.sym
** sch_path: /run/media/yacinesot/My_Files/XschemDesigns/designs/Chipalooza2/schema/ota_cmfb_core/ota_cmfb_core_push_pull_output_stage.sch
.subckt ota_cmfb_core_push_pull_output_stage VDD Vin Vout Vbias VSS EN
*.PININFO VSS:B VDD:B Vbias:I Vin:I Vout:O EN:I
MM1 Vout Vin_shifted VSS VSS sg13_lv_nmos w=0.5u l=10u ng=1
MM2 VDD Vin Vout VDD sg13_lv_pmos w=5u l=0.5u ng=1
MMC VDD Vbiasp CD_DRN VDD sg13_lv_pmos w=2.5u l=3u ng=1 m=4
MME Vin_shifted Vcasp2 Vin VDD sg13_lv_pmos w=2.5u l=3u ng=1 m=2
MMD CD_DRN Vcasp Vin VDD sg13_lv_pmos w=2.5u l=3u ng=1 m=4
MMN Vin Vcasn2 Vin_shifted VSS sg13_lv_nmos w=0.7u l=3u ng=1 m=2
MMH VDD Vbiasp net1 VDD sg13_lv_pmos w=2.5u l=3u ng=1 m=4
MMI net1 Vcasp Vcasp VDD sg13_lv_pmos w=2.5u l=3u ng=1 m=4
MMJ Vcasp Vcasp2 Vcasp2 VDD sg13_lv_pmos w=2.5u l=3u ng=1 m=4
MMB VDD Vbiasp Vcasn2 VDD sg13_lv_pmos w=2.5u l=3u ng=1 m=4
MMO Vcasn2 Vcasn2 Vcasn VSS sg13_lv_nmos w=0.7u l=3u ng=1 m=4
RR1 net2 Vout 23.97k $SUB=VSS $[rhigh] w=0.5e-6 l=1e-6*8 b=0
CC1 Vin net2 sg13_moscap_p w=3.5u l=21.5u
MMFG Vbiasp Vbias VSS VSS sg13_lv_nmos w=0.25u l=10u ng=1 m=2
MMA VDD Vbiasp Vbiasp VDD sg13_lv_pmos w=2.5u l=3u ng=1 m=10
MMP Vcasn Vcasn Vbiasn VSS sg13_lv_nmos w=0.7u l=3u ng=1 m=4
MMQ Vbiasn Vbiasn VSS VSS sg13_lv_nmos w=0.7u l=3u ng=1 m=4
MMM Vin_shifted Vcasn src_ml VSS sg13_lv_nmos w=0.7u l=3u ng=1 m=4
MML src_ml Vbiasn VSS VSS sg13_lv_nmos w=0.7u l=3u ng=1 m=4
MMK Vcasp2 Vbiasn VSS VSS sg13_lv_nmos w=0.7u l=3u ng=1 m=4
MM3 CD_DRN VDD VDD VDD sg13_lv_pmos w=2.5u l=0.5u ng=1 m=2
MM4 Vin_shifted VDD VDD VDD sg13_lv_pmos w=2.5u l=0.5u ng=1
MM5 Vbiasp VDD VDD VDD sg13_lv_pmos w=2.5u l=0.5u ng=1
MM6 Vin VDD VDD VDD sg13_lv_pmos w=2.5u l=0.5u ng=1
MM7 VSS VSS Vin_shifted VSS sg13_lv_nmos w=0.7u l=0.5u ng=1 m=2
MM8 VSS VSS Vcasn VSS sg13_lv_nmos w=0.7u l=0.5u ng=1 m=4
MMX VSS VSS Vin_shifted VSS sg13_lv_nmos w=0.7u l=3u ng=1 m=4
MM9 VSS VSS src_ml VSS sg13_lv_nmos w=0.7u l=0.5u ng=1 m=4
MM10 Vcasp VDD VDD VDD sg13_lv_pmos w=2.5u l=0.5u ng=1 m=2
MM12 VSS VSS Vbiasp VSS sg13_lv_nmos w=0.25u l=0.5u ng=1 m=2
MM13 Vbiasp EN VDD VDD sg13_lv_pmos w=0.15u l=0.13u ng=1
MMN0 EN_N EN VSS VSS sg13_lv_nmos w=2.96u l=130.00n ng=1
MMP0 EN_N EN VDD VDD sg13_lv_pmos w=4.48u l=130.00n ng=1
MMN1 Vbiasn EN_N VSS VSS sg13_lv_nmos w=740.00n l=130.00n ng=1
MM14 Vin EN VDD VDD sg13_lv_pmos w=0.15u l=0.13u ng=1
.ends
