YacineSot/sg13cmos5l_yacinesot_ip__diff_opamp_cmfb/pex/ota_cmfb_top_pex.spice/final.gds.spice

* NGSPICE file created from ota_cmfb_top.ext - technology: ihp-sg13g2

.subckt ota_cmfb_top VDD VSS EN Vinp Vinn VCM Ibias Voutp Voutn
X0 ota_cmfb_core_push_pull_output_stage_1/dynamic_pcell$4_0.Gate ota_cmfb_core_push_pull_output_stage_1/dynamic_pcell$4_0.Gate VSS VSS sg13_lv_nmos ad=0.133p pd=1.08u as=0.133p ps=1.08u w=0.7u l=3u
X1 ota_cmfb_core_push_pull_output_stage_0/dynamic_pcell$4_0.Gate ota_cmfb_core_push_pull_output_stage_0/dynamic_pcell$4_0.Gate VSS VSS sg13_lv_nmos ad=0.133p pd=1.08u as=0.133p ps=1.08u w=0.7u l=3u
X2 VDD EN EN_INV_0/sg13cmos5l_inv_4_0.Y VDD sg13_lv_pmos ad=0.3808p pd=2.92u as=0.2128p ps=1.5u w=1.12u l=0.13u
X3 VDD dynamic_pcell_0.Gate dynamic_pcell_0.M_DRN VDD sg13_lv_pmos ad=0.475p pd=2.88u as=0.475p ps=2.88u w=2.5u l=10u
X4 dynamic_pcell$5_0.F_DRN VSS VSS VSS sg13_lv_nmos ad=62.5f pd=0.74u as=62.5f ps=0.74u w=0.25u l=0.5u
X5 VSS ota_cmfb_core_push_pull_output_stage_1/dynamic_pcell$4_0.Gate ota_cmfb_core_push_pull_output_stage_1/dynamic_pcell$4_0.SRC_NET_ML VSS sg13_lv_nmos ad=0.133p pd=1.08u as=0.133p ps=1.08u w=0.7u l=3u
X6 VDD VDD VDD VDD sg13_lv_pmos ad=95f pd=0.88u as=0.99271n ps=3.29565m w=0.5u l=0.5u
X7 dynamic_pcell$5_0.F_DRN dynamic_pcell$5_0.F_DRN VDD VDD sg13_lv_pmos ad=0.475p pd=2.88u as=0.475p ps=2.88u w=2.5u l=3u
X8 ota_cmfb_core_push_pull_output_stage_0/dynamic_pcell$4_0.DRN_NET_CD VDD VDD VDD sg13_lv_pmos ad=0.475p pd=2.88u as=0.475p ps=2.88u w=2.5u l=0.5u
X9 ota_cmfb_core_push_pull_output_stage_0/dynamic_pcell$4_0.SRC_NET_IJ_GATE_DI VDD VDD VDD sg13_lv_pmos ad=0.475p pd=2.88u as=0.475p ps=2.88u w=2.5u l=0.5u
X10 VDD VDD VDD VDD sg13_lv_pmos ad=95f pd=0.88u as=0 ps=0 w=0.5u l=0.5u
X11 VDD dynamic_pcell$6_0.Gate dynamic_pcell$6_0.Gate VDD sg13_lv_pmos ad=0.2375p pd=1.63u as=0.2375p ps=1.63u w=1.25u l=5u
X12 VDD VDD VDD VDD sg13_lv_pmos ad=0.85p pd=5.68u as=0 ps=0 w=2.5u l=0.5u
X13 ota_cmfb_core_push_pull_output_stage_1/dynamic_pcell$4_0.DRN_NET_OP_GATE_MP ota_cmfb_core_push_pull_output_stage_1/dynamic_pcell$4_0.B_DRN ota_cmfb_core_push_pull_output_stage_1/dynamic_pcell$4_0.B_DRN VSS sg13_lv_nmos ad=0.133p pd=1.08u as=0.133p ps=1.08u w=0.7u l=3u
X14 VDD VDD VDD VDD sg13_lv_pmos ad=0.85p pd=5.68u as=0 ps=0 w=2.5u l=0.5u
X15 VDD dynamic_pcell$5_0.G_DRN ota_cmfb_core_push_pull_output_stage_1/dynamic_pcell$4_0.DRN_NET_CD VDD sg13_lv_pmos ad=0.475p pd=2.88u as=0.475p ps=2.88u w=2.5u l=3u
X16 VDD VDD VDD VDD sg13_lv_pmos ad=0.85p pd=5.68u as=0 ps=0 w=2.5u l=0.5u
X17 dynamic_pcell$5_0.DRN_NET_CA Vinp dynamic_pcell_0.M_DRN VDD sg13_lv_pmos ad=0.475p pd=2.88u as=0.85p ps=5.68u w=2.5u l=2u
X18 ota_cmfb_core_push_pull_output_stage_1/dynamic_pcell$4_0.DRN_NET_J_GATE_EJ ota_cmfb_core_push_pull_output_stage_1/dynamic_pcell$4_0.DRN_NET_J_GATE_EJ ota_cmfb_core_push_pull_output_stage_1/dynamic_pcell$4_0.SRC_NET_IJ_GATE_DI VDD sg13_lv_pmos ad=0.475p pd=2.88u as=0.475p ps=2.88u w=2.5u l=3u
X19 ota_cmfb_core_push_pull_output_stage_1/dynamic_pcell$4_0.DRN_NET_J_GATE_EJ ota_cmfb_core_push_pull_output_stage_1/dynamic_pcell$4_0.DRN_NET_J_GATE_EJ ota_cmfb_core_push_pull_output_stage_1/dynamic_pcell$4_0.SRC_NET_IJ_GATE_DI VDD sg13_lv_pmos ad=0.475p pd=2.88u as=0.475p ps=2.88u w=2.5u l=3u
X20 VDD VDD VDD VDD sg13_lv_pmos ad=95f pd=0.88u as=0 ps=0 w=0.5u l=0.5u
X21 VDD dynamic_pcell$5_0.G_DRN dynamic_pcell$5_0.G_DRN VDD sg13_lv_pmos ad=0.475p pd=2.88u as=0.475p ps=2.88u w=2.5u l=3u
X22 VSS VSS ota_cmfb_core_push_pull_output_stage_1/dynamic_pcell$4_0.DRN_NET_MENX VSS sg13_lv_nmos ad=0.133p pd=1.08u as=0.133p ps=1.08u w=0.7u l=3u
X23 VDD dynamic_pcell$5_0.G_DRN ota_cmfb_core_push_pull_output_stage_1/dynamic_pcell$4_0.B_DRN VDD sg13_lv_pmos ad=0.475p pd=2.88u as=0.475p ps=2.88u w=2.5u l=3u
X24 dynamic_pcell_0.Gate dynamic_pcell$5_0.Gate VSS VSS sg13_lv_nmos ad=62.5f pd=0.74u as=62.5f ps=0.74u w=0.25u l=10u
X25 VDD dynamic_pcell$5_0.G_DRN ota_cmfb_core_push_pull_output_stage_1/dynamic_pcell$4_0.DRN_NET_HI VDD sg13_lv_pmos ad=0.475p pd=2.88u as=0.475p ps=2.88u w=2.5u l=3u
X26 VSS VSS VSS VSS sg13_lv_nmos ad=0.17p pd=1.68u as=0.80533n ps=2.51841m w=0.5u l=0.5u
X27 VSS EN EN_INV_1/sg13cmos5l_inv_4_0.Y VSS sg13_lv_nmos ad=0.2516p pd=2.16u as=0.1406p ps=1.12u w=0.74u l=0.13u
X28 VSS ota_cmfb_core_push_pull_output_stage_0/dynamic_pcell$4_0.Gate ota_cmfb_core_push_pull_output_stage_0/dynamic_pcell$4_0.DRN_NET_J_GATE_EJ VSS sg13_lv_nmos ad=0.133p pd=1.08u as=0.133p ps=1.08u w=0.7u l=3u
X29 VSS VSS ota_cmfb_core_push_pull_output_stage_1/dynamic_pcell$4_0.DRN_NET_MENX VSS sg13_lv_nmos ad=0.133p pd=1.08u as=0.133p ps=1.08u w=0.7u l=3u
X30 VSS Ibias dynamic_pcell$5_0.DRN_NET_CA VSS sg13_lv_nmos ad=62.5f pd=0.74u as=62.5f ps=0.74u w=0.25u l=10u
X31 VDD VDD VDD VDD sg13_lv_pmos ad=0.475p pd=2.88u as=0 ps=0 w=2.5u l=0.5u
X32 dynamic_pcell$6_0.Gate VSS VSS VSS sg13_lv_nmos ad=62.5f pd=0.74u as=62.5f ps=0.74u w=0.25u l=0.5u
X33 dynamic_pcell_0.M_DRN Vinn dynamic_pcell$5_0.DRN_NET_BD VDD sg13_lv_pmos ad=0.85p pd=5.68u as=0.475p ps=2.88u w=2.5u l=2u
X34 VDD VDD VDD VDD sg13_lv_pmos ad=0.85p pd=5.68u as=0 ps=0 w=2.5u l=0.5u
X35 dynamic_pcell$5_0.DRN_NET_CA ota_cmfb_core_push_pull_output_stage_1/dynamic_pcell$4_0.SRC_NET_IJ_GATE_DI ota_cmfb_core_push_pull_output_stage_1/dynamic_pcell$4_0.DRN_NET_CD VDD sg13_lv_pmos ad=0.475p pd=2.88u as=0.85p ps=5.68u w=2.5u l=3u
X36 VSS ota_cmfb_core_push_pull_output_stage_0/dynamic_pcell$4_0.DRN_NET_MENX Voutp VSS sg13_lv_nmos ad=0.17p pd=1.68u as=0.17p ps=1.68u w=0.5u l=10u
X37 VDD VDD VDD VDD sg13_lv_pmos ad=0.475p pd=2.88u as=0 ps=0 w=2.5u l=0.5u
X38 ota_cmfb_core_push_pull_output_stage_1/dynamic_pcell$4_0.SRC_NET_ML ota_cmfb_core_push_pull_output_stage_1/dynamic_pcell$4_0.DRN_NET_OP_GATE_MP ota_cmfb_core_push_pull_output_stage_1/dynamic_pcell$4_0.DRN_NET_MENX VSS sg13_lv_nmos ad=0.133p pd=1.08u as=0.133p ps=1.08u w=0.7u l=3u
X39 dynamic_pcell$5_0.F_DRN VDD VDD VDD sg13_lv_pmos ad=0.475p pd=2.88u as=0.475p ps=2.88u w=2.5u l=0.5u
X40 EN_INV_0/sg13cmos5l_inv_4_0.Y EN VSS VSS sg13_lv_nmos ad=0.1406p pd=1.12u as=0.1406p ps=1.12u w=0.74u l=0.13u
X41 VDD dynamic_pcell$6_0.Gate dynamic_pcell$6_0.DRN_NET_O VDD sg13_lv_pmos ad=0.2375p pd=1.63u as=0.2375p ps=1.63u w=1.25u l=5u
X42 VDD VDD VDD VDD sg13_lv_pmos ad=0.2375p pd=1.63u as=0 ps=0 w=1.25u l=0.5u
X43 a_n235_n1629# a_29_n1915# VSS rhigh l=1u w=0.5u
X44 VDD VDD VDD VDD sg13_lv_pmos ad=0.475p pd=2.88u as=0 ps=0 w=2.5u l=0.5u
X45 VSS VSS VSS VSS sg13_lv_nmos ad=0.238p pd=2.08u as=0 ps=0 w=0.7u l=0.5u
X46 ota_cmfb_core_push_pull_output_stage_1/dynamic_pcell$4_0.SRC_NET_ML ota_cmfb_core_push_pull_output_stage_1/dynamic_pcell$4_0.DRN_NET_OP_GATE_MP ota_cmfb_core_push_pull_output_stage_1/dynamic_pcell$4_0.DRN_NET_MENX VSS sg13_lv_nmos ad=0.133p pd=1.08u as=0.133p ps=1.08u w=0.7u l=3u
X47 a_29_n2190# a_n235_n2476# VSS rhigh l=1u w=0.5u
X48 VDD dynamic_pcell$5_0.G_DRN dynamic_pcell$5_0.G_DRN VDD sg13_lv_pmos ad=0.475p pd=2.88u as=0.475p ps=2.88u w=2.5u l=3u
X49 VDD VDD VDD VDD sg13_lv_pmos ad=0.85p pd=5.68u as=0 ps=0 w=2.5u l=0.5u
X50 ota_cmfb_core_push_pull_output_stage_1/dynamic_pcell$4_0.Gate ota_cmfb_core_push_pull_output_stage_1/dynamic_pcell$4_0.DRN_NET_OP_GATE_MP ota_cmfb_core_push_pull_output_stage_1/dynamic_pcell$4_0.DRN_NET_OP_GATE_MP VSS sg13_lv_nmos ad=0.133p pd=1.08u as=0.133p ps=1.08u w=0.7u l=3u
X51 a_8827_4832# a_9091_4546# VSS rhigh l=1u w=0.5u
X52 dynamic_pcell$6_0.DRN_NET_O dynamic_pcell$6_0.Gate VDD VDD sg13_lv_pmos ad=0.2375p pd=1.63u as=0.2375p ps=1.63u w=1.25u l=5u
X53 VSS VSS dynamic_pcell$5_0.F_DRN VSS sg13_lv_nmos ad=62.5f pd=0.74u as=62.5f ps=0.74u w=0.25u l=0.5u
X54 Ibias EN_INV_0/sg13cmos5l_inv_4_0.Y VSS VSS sg13_lv_nmos ad=0.2516p pd=2.16u as=0.2516p ps=2.16u w=0.74u l=0.13u
X55 ota_cmfb_core_push_pull_output_stage_1/dynamic_pcell$4_0.B_DRN ota_cmfb_core_push_pull_output_stage_1/dynamic_pcell$4_0.B_DRN ota_cmfb_core_push_pull_output_stage_1/dynamic_pcell$4_0.DRN_NET_OP_GATE_MP VSS sg13_lv_nmos ad=0.133p pd=1.08u as=0.133p ps=1.08u w=0.7u l=3u
X56 dynamic_pcell$5_0.DRN_NET_CA ota_cmfb_core_push_pull_output_stage_1/dynamic_pcell$4_0.DRN_NET_J_GATE_EJ ota_cmfb_core_push_pull_output_stage_1/dynamic_pcell$4_0.DRN_NET_MENX VDD sg13_lv_pmos ad=0.475p pd=2.88u as=0.85p ps=5.68u w=2.5u l=3u
X57 VDD dynamic_pcell$5_0.G_DRN dynamic_pcell$5_0.G_DRN VDD sg13_lv_pmos ad=0.85p pd=5.68u as=0.475p ps=2.88u w=2.5u l=3u
X58 VDD VDD VDD VDD sg13_lv_pmos ad=0.2375p pd=1.63u as=0 ps=0 w=1.25u l=0.5u
X59 VSS VSS VSS VSS sg13_lv_nmos ad=95f pd=0.88u as=0 ps=0 w=0.5u l=0.5u
X60 VSS Ibias dynamic_pcell$5_0.DRN_NET_BD VSS sg13_lv_nmos ad=62.5f pd=0.74u as=62.5f ps=0.74u w=0.25u l=10u
X61 ota_cmfb_core_push_pull_output_stage_1/dynamic_pcell$4_0.DRN_NET_HI ota_cmfb_core_push_pull_output_stage_1/dynamic_pcell$4_0.SRC_NET_IJ_GATE_DI ota_cmfb_core_push_pull_output_stage_1/dynamic_pcell$4_0.SRC_NET_IJ_GATE_DI VDD sg13_lv_pmos ad=0.475p pd=2.88u as=0.85p ps=5.68u w=2.5u l=3u
X62 VDD dynamic_pcell$5_0.DRN_NET_CA Voutn VDD sg13_lv_pmos ad=95f pd=0.88u as=95f ps=0.88u w=0.5u l=0.5u
X63 VDD dynamic_pcell$5_0.F_DRN ota_cmfb_core_push_pull_output_stage_0/dynamic_pcell$4_0.B_DRN VDD sg13_lv_pmos ad=0.85p pd=5.68u as=0.475p ps=2.88u w=2.5u l=3u
X64 Ibias VSS VSS VSS sg13_lv_nmos ad=62.5f pd=0.74u as=62.5f ps=0.74u w=0.25u l=0.5u
X65 ota_cmfb_core_push_pull_output_stage_1/dynamic_pcell$4_0.DRN_NET_CD ota_cmfb_core_push_pull_output_stage_1/dynamic_pcell$4_0.SRC_NET_IJ_GATE_DI dynamic_pcell$5_0.DRN_NET_CA VDD sg13_lv_pmos ad=0.85p pd=5.68u as=0.475p ps=2.88u w=2.5u l=3u
X66 a_1349_n1629# Voutp VSS rhigh l=1u w=0.5u
X67 a_2622_4832# a_2358_4546# VSS rhigh l=1u w=0.5u
X68 ota_cmfb_core_push_pull_output_stage_1/dynamic_pcell$4_0.B_DRN dynamic_pcell$5_0.G_DRN VDD VDD sg13_lv_pmos ad=0.475p pd=2.88u as=0.85p ps=5.68u w=2.5u l=3u
X69 ota_cmfb_core_push_pull_output_stage_1/dynamic_pcell$4_0.DRN_NET_HI dynamic_pcell$5_0.G_DRN VDD VDD sg13_lv_pmos ad=0.475p pd=2.88u as=0.85p ps=5.68u w=2.5u l=3u
X70 ota_cmfb_core_push_pull_output_stage_1/dynamic_pcell$4_0.SRC_NET_IJ_GATE_DI ota_cmfb_core_push_pull_output_stage_1/dynamic_pcell$4_0.SRC_NET_IJ_GATE_DI ota_cmfb_core_push_pull_output_stage_1/dynamic_pcell$4_0.DRN_NET_HI VDD sg13_lv_pmos ad=0.85p pd=5.68u as=0.475p ps=2.88u w=2.5u l=3u
X71 Voutn a_1349_n2476# VSS rhigh l=1u w=0.5u
X72 dynamic_pcell$5_0.DRN_NET_BD Vinn dynamic_pcell_0.M_DRN VDD sg13_lv_pmos ad=0.475p pd=2.88u as=0.475p ps=2.88u w=2.5u l=2u
X73 ota_cmfb_core_push_pull_output_stage_1/dynamic_pcell$4_0.Gate ota_cmfb_core_push_pull_output_stage_1/dynamic_pcell$4_0.DRN_NET_OP_GATE_MP ota_cmfb_core_push_pull_output_stage_1/dynamic_pcell$4_0.DRN_NET_OP_GATE_MP VSS sg13_lv_nmos ad=0.133p pd=1.08u as=0.133p ps=1.08u w=0.7u l=3u
X74 Voutn dynamic_pcell$5_0.DRN_NET_CA VDD VDD sg13_lv_pmos ad=95f pd=0.88u as=95f ps=0.88u w=0.5u l=0.5u
X75 VDD VDD VDD VDD sg13_lv_pmos ad=0.475p pd=2.88u as=0 ps=0 w=2.5u l=0.5u
X76 VDD VDD dynamic_pcell$5_0.Gate VDD sg13_lv_pmos ad=0.475p pd=2.88u as=0.475p ps=2.88u w=2.5u l=0.5u
X77 VSS VSS VSS VSS sg13_lv_nmos ad=0.238p pd=2.08u as=0 ps=0 w=0.7u l=0.5u
X78 a_293_n1629# a_557_n1915# VSS rhigh l=1u w=0.5u
X79 VDD VDD ota_cmfb_core_push_pull_output_stage_0/dynamic_pcell$4_0.SRC_NET_IJ_GATE_DI VDD sg13_lv_pmos ad=0.475p pd=2.88u as=0.475p ps=2.88u w=2.5u l=0.5u
X80 VDD VDD VDD VDD sg13_lv_pmos ad=0.85p pd=5.68u as=0 ps=0 w=2.5u l=0.5u
X81 VDD VDD VDD VDD sg13_lv_pmos ad=0.85p pd=5.68u as=0 ps=0 w=2.5u l=0.5u
X82 a_557_n2190# a_293_n2476# VSS rhigh l=1u w=0.5u
X83 VSS ota_cmfb_core_push_pull_output_stage_1/dynamic_pcell$4_0.Gate ota_cmfb_core_push_pull_output_stage_1/dynamic_pcell$4_0.SRC_NET_ML VSS sg13_lv_nmos ad=0.133p pd=1.08u as=0.133p ps=1.08u w=0.7u l=3u
X84 VDD VDD VDD VDD sg13_lv_pmos ad=0.85p pd=5.68u as=0 ps=0 w=2.5u l=0.5u
X85 VSS VSS ota_cmfb_core_push_pull_output_stage_1/dynamic_pcell$4_0.SRC_NET_ML VSS sg13_lv_nmos ad=0.133p pd=1.08u as=0.133p ps=1.08u w=0.7u l=0.5u
X86 ota_cmfb_core_push_pull_output_stage_1/dynamic_pcell$4_0.DRN_NET_MENX ota_cmfb_core_push_pull_output_stage_1/dynamic_pcell$4_0.DRN_NET_OP_GATE_MP ota_cmfb_core_push_pull_output_stage_1/dynamic_pcell$4_0.SRC_NET_ML VSS sg13_lv_nmos ad=0.133p pd=1.08u as=0.133p ps=1.08u w=0.7u l=3u
X87 VDD VDD VDD VDD sg13_lv_pmos ad=95f pd=0.88u as=0 ps=0 w=0.5u l=0.5u
X88 VSS Ibias dynamic_pcell$5_0.DRN_NET_BD VSS sg13_lv_nmos ad=62.5f pd=0.74u as=62.5f ps=0.74u w=0.25u l=10u
X89 VSS VSS VSS VSS sg13_lv_nmos ad=0.17p pd=1.68u as=0 ps=0 w=0.5u l=0.5u
X90 dynamic_pcell$5_0.Gate EN_INV_1/sg13cmos5l_inv_4_0.Y VSS VSS sg13_lv_nmos ad=0.2516p pd=2.16u as=0.2516p ps=2.16u w=0.74u l=0.13u
X91 VDD VDD VDD VDD sg13_lv_pmos ad=0.2375p pd=1.63u as=0 ps=0 w=1.25u l=0.5u
X92 VSS VSS VSS VSS sg13_lv_nmos ad=62.5f pd=0.74u as=0 ps=0 w=0.25u l=0.5u
X93 VDD VDD VDD VDD sg13_lv_pmos ad=0.475p pd=2.88u as=0 ps=0 w=2.5u l=0.5u
X94 VDD VDD VDD VDD sg13_lv_pmos ad=0.475p pd=2.88u as=0 ps=0 w=2.5u l=0.5u
X95 dynamic_pcell$5_0.DRN_NET_CA ota_cmfb_core_push_pull_output_stage_1/dynamic_pcell$4_0.B_DRN ota_cmfb_core_push_pull_output_stage_1/dynamic_pcell$4_0.DRN_NET_MENX VSS sg13_lv_nmos ad=0.133p pd=1.08u as=0.133p ps=1.08u w=0.7u l=3u
X96 VSS VSS VSS VSS sg13_lv_nmos ad=95f pd=0.88u as=0 ps=0 w=0.5u l=0.5u
X97 dynamic_pcell$6_0.Gate VDD VDD VDD sg13_lv_pmos ad=0.2375p pd=1.63u as=0.2375p ps=1.63u w=1.25u l=0.5u
X98 dynamic_pcell$5_0.G_DRN dynamic_pcell$5_0.G_DRN VDD VDD sg13_lv_pmos ad=0.475p pd=2.88u as=0.475p ps=2.88u w=2.5u l=3u
X99 VDD VDD ota_cmfb_core_push_pull_output_stage_1/dynamic_pcell$4_0.DRN_NET_CD VDD sg13_lv_pmos ad=0.475p pd=2.88u as=0.475p ps=2.88u w=2.5u l=0.5u
X100 VSS VSS VSS VSS sg13_lv_nmos ad=0.238p pd=2.08u as=0 ps=0 w=0.7u l=0.5u
X101 VDD VDD VDD VDD sg13_lv_pmos ad=0.425p pd=3.18u as=0 ps=0 w=1.25u l=0.5u
X102 dynamic_pcell_0.M_DRN dynamic_pcell_0.Gate VDD VDD sg13_lv_pmos ad=0.475p pd=2.88u as=0.475p ps=2.88u w=2.5u l=10u
X103 ota_cmfb_core_push_pull_output_stage_1/dynamic_pcell$4_0.DRN_NET_OP_GATE_MP ota_cmfb_core_push_pull_output_stage_1/dynamic_pcell$4_0.B_DRN ota_cmfb_core_push_pull_output_stage_1/dynamic_pcell$4_0.B_DRN VSS sg13_lv_nmos ad=0.133p pd=1.08u as=0.133p ps=1.08u w=0.7u l=3u
X104 VDD VDD dynamic_pcell_0.M_DRN VDD sg13_lv_pmos ad=0.475p pd=2.88u as=0.475p ps=2.88u w=2.5u l=0.5u
X105 VSS VSS VSS VSS sg13_lv_nmos ad=95f pd=0.88u as=0 ps=0 w=0.5u l=0.5u
X106 VSS VSS VSS VSS sg13_lv_nmos ad=0.133p pd=1.08u as=0 ps=0 w=0.7u l=0.5u
X107 dynamic_pcell$5_0.F_DRN Ibias VSS VSS sg13_lv_nmos ad=62.5f pd=0.74u as=62.5f ps=0.74u w=0.25u l=10u
X108 a_n763_n1629# dynamic_pcell$5_0.L_GATE VSS rhigh l=1u w=0.5u
X109 VDD VDD VDD VDD sg13_lv_pmos ad=0.85p pd=5.68u as=0 ps=0 w=2.5u l=0.5u
X110 VSS VSS VSS VSS sg13_lv_nmos ad=62.5f pd=0.74u as=0 ps=0 w=0.25u l=0.5u
X111 VDD VDD VDD VDD sg13_lv_pmos ad=95f pd=0.88u as=0 ps=0 w=0.5u l=0.5u
X112 dynamic_pcell$5_0.L_GATE a_n763_n2476# VSS rhigh l=1u w=0.5u
X113 VSS Ibias dynamic_pcell$5_0.G_DRN VSS sg13_lv_nmos ad=62.5f pd=0.74u as=62.5f ps=0.74u w=0.25u l=10u
X114 VSS VSS VSS VSS sg13_lv_nmos ad=62.5f pd=0.74u as=0 ps=0 w=0.25u l=0.5u
X115 VDD VDD VDD VDD sg13_lv_pmos ad=0.475p pd=2.88u as=0 ps=0 w=2.5u l=0.5u
X116 dynamic_pcell_0.M_DRN dynamic_pcell_0.Gate VDD VDD sg13_lv_pmos ad=0.475p pd=2.88u as=0.475p ps=2.88u w=2.5u l=10u
X117 ota_cmfb_core_push_pull_output_stage_1/dynamic_pcell$4_0.Gate ota_cmfb_core_push_pull_output_stage_1/dynamic_pcell$4_0.Gate VSS VSS sg13_lv_nmos ad=0.133p pd=1.08u as=0.133p ps=1.08u w=0.7u l=3u
X118 dynamic_pcell_0.M_DRN Vinn dynamic_pcell$5_0.DRN_NET_BD VDD sg13_lv_pmos ad=0.475p pd=2.88u as=0.475p ps=2.88u w=2.5u l=2u
X119 VSS VSS VSS VSS sg13_lv_nmos ad=95f pd=0.88u as=0 ps=0 w=0.5u l=0.5u
X120 VSS VSS VSS VSS sg13_lv_nmos ad=95f pd=0.88u as=0 ps=0 w=0.5u l=0.5u
X121 Voutp dynamic_pcell$5_0.DRN_NET_BD VDD VDD sg13_lv_pmos ad=95f pd=0.88u as=95f ps=0.88u w=0.5u l=0.5u
X122 ota_cmfb_core_push_pull_output_stage_1/dynamic_pcell$4_0.DRN_NET_CD dynamic_pcell$5_0.G_DRN VDD VDD sg13_lv_pmos ad=0.475p pd=2.88u as=0.475p ps=2.88u w=2.5u l=3u
X123 EN_INV_1/sg13cmos5l_inv_4_0.Y EN VDD VDD sg13_lv_pmos ad=0.2128p pd=1.5u as=0.3808p ps=2.92u w=1.12u l=0.13u
X124 VDD VDD dynamic_pcell$6_0.Gate VDD sg13_lv_pmos ad=0.2375p pd=1.63u as=0.2375p ps=1.63u w=1.25u l=0.5u
X125 dynamic_pcell_0.Gate dynamic_pcell$5_0.L_GATE dynamic_pcell$6_0.DRN_NET_O VDD sg13_lv_pmos ad=0.85p pd=5.68u as=0.475p ps=2.88u w=2.5u l=2u
X126 VDD VDD VDD VDD sg13_lv_pmos ad=0.85p pd=5.68u as=0 ps=0 w=2.5u l=0.5u
X127 ota_cmfb_core_push_pull_output_stage_1/dynamic_pcell$4_0.SRC_NET_IJ_GATE_DI ota_cmfb_core_push_pull_output_stage_1/dynamic_pcell$4_0.DRN_NET_J_GATE_EJ ota_cmfb_core_push_pull_output_stage_1/dynamic_pcell$4_0.DRN_NET_J_GATE_EJ VDD sg13_lv_pmos ad=0.475p pd=2.88u as=0.475p ps=2.88u w=2.5u l=3u
X128 VSS VSS VSS VSS sg13_lv_nmos ad=0.238p pd=2.08u as=0 ps=0 w=0.7u l=0.5u
X129 dynamic_pcell$6_0.Gate dynamic_pcell$6_0.Gate VDD VDD sg13_lv_pmos ad=0.2375p pd=1.63u as=0.2375p ps=1.63u w=1.25u l=5u
X130 VDD dynamic_pcell_0.Gate dynamic_pcell_0.M_DRN VDD sg13_lv_pmos ad=0.475p pd=2.88u as=0.475p ps=2.88u w=2.5u l=10u
X131 ota_cmfb_core_push_pull_output_stage_0/dynamic_pcell$4_0.SRC_NET_ML VSS VSS VSS sg13_lv_nmos ad=0.133p pd=1.08u as=0.133p ps=1.08u w=0.7u l=0.5u
X132 ota_cmfb_core_push_pull_output_stage_1/dynamic_pcell$4_0.DRN_NET_MENX VSS VSS VSS sg13_lv_nmos ad=0.133p pd=1.08u as=0.133p ps=1.08u w=0.7u l=3u
X133 Voutn dynamic_pcell$5_0.DRN_NET_CA VDD VDD sg13_lv_pmos ad=95f pd=0.88u as=95f ps=0.88u w=0.5u l=0.5u
X134 ota_cmfb_core_push_pull_output_stage_0/dynamic_pcell$4_0.DRN_NET_CD ota_cmfb_core_push_pull_output_stage_0/dynamic_pcell$4_0.SRC_NET_IJ_GATE_DI dynamic_pcell$5_0.DRN_NET_BD VDD sg13_lv_pmos ad=0.475p pd=2.88u as=0.475p ps=2.88u w=2.5u l=3u
X135 VDD VDD ota_cmfb_core_push_pull_output_stage_1/dynamic_pcell$4_0.SRC_NET_IJ_GATE_DI VDD sg13_lv_pmos ad=0.475p pd=2.88u as=0.475p ps=2.88u w=2.5u l=0.5u
X136 VSS VSS ota_cmfb_core_push_pull_output_stage_1/dynamic_pcell$4_0.DRN_NET_OP_GATE_MP VSS sg13_lv_nmos ad=0.133p pd=1.08u as=0.133p ps=1.08u w=0.7u l=0.5u
X137 VSS VSS VSS VSS sg13_lv_nmos ad=62.5f pd=0.74u as=0 ps=0 w=0.25u l=0.5u
X138 Voutn dynamic_pcell$5_0.DRN_NET_CA VDD VDD sg13_lv_pmos ad=95f pd=0.88u as=95f ps=0.88u w=0.5u l=0.5u
X139 VDD dynamic_pcell$5_0.G_DRN ota_cmfb_core_push_pull_output_stage_1/dynamic_pcell$4_0.DRN_NET_CD VDD sg13_lv_pmos ad=0.475p pd=2.88u as=0.475p ps=2.88u w=2.5u l=3u
X140 ota_cmfb_core_push_pull_output_stage_1/dynamic_pcell$4_0.DRN_NET_CD ota_cmfb_core_push_pull_output_stage_1/dynamic_pcell$4_0.SRC_NET_IJ_GATE_DI dynamic_pcell$5_0.DRN_NET_CA VDD sg13_lv_pmos ad=0.475p pd=2.88u as=0.475p ps=2.88u w=2.5u l=3u
X141 a_2358_4309# a_2094_4023# VSS rhigh l=1u w=0.5u
X142 VSS VSS VSS VSS sg13_lv_nmos ad=0.17p pd=1.68u as=0 ps=0 w=0.5u l=0.5u
X143 VSS dynamic_pcell$5_0.Gate dynamic_pcell$5_0.Gate VSS sg13_lv_nmos ad=62.5f pd=0.74u as=62.5f ps=0.74u w=0.25u l=10u
X144 VSS VSS dynamic_pcell$5_0.G_DRN VSS sg13_lv_nmos ad=62.5f pd=0.74u as=62.5f ps=0.74u w=0.25u l=0.5u
X145 dynamic_pcell$5_0.DRN_NET_BD Vinn dynamic_pcell_0.M_DRN VDD sg13_lv_pmos ad=0.475p pd=2.88u as=0.475p ps=2.88u w=2.5u l=2u
X146 VSS ota_cmfb_core_push_pull_output_stage_1/dynamic_pcell$4_0.Gate ota_cmfb_core_push_pull_output_stage_1/dynamic_pcell$4_0.DRN_NET_J_GATE_EJ VSS sg13_lv_nmos ad=0.133p pd=1.08u as=0.133p ps=1.08u w=0.7u l=3u
X147 dynamic_pcell_0.Gate dynamic_pcell$5_0.Gate VSS VSS sg13_lv_nmos ad=62.5f pd=0.74u as=62.5f ps=0.74u w=0.25u l=10u
X148 dynamic_pcell_0.Gate dynamic_pcell$5_0.L_GATE dynamic_pcell$6_0.DRN_NET_O VDD sg13_lv_pmos ad=0.475p pd=2.88u as=0.85p ps=5.68u w=2.5u l=2u
X149 VDD VDD VDD VDD sg13_lv_pmos ad=95f pd=0.88u as=0 ps=0 w=0.5u l=0.5u
X150 ota_cmfb_core_push_pull_output_stage_1/dynamic_pcell$4_0.DRN_NET_MENX VDD VDD VDD sg13_lv_pmos ad=0.475p pd=2.88u as=0.475p ps=2.88u w=2.5u l=0.5u
X151 VSS ota_cmfb_core_push_pull_output_stage_1/dynamic_pcell$4_0.Gate ota_cmfb_core_push_pull_output_stage_1/dynamic_pcell$4_0.Gate VSS sg13_lv_nmos ad=0.133p pd=1.08u as=0.133p ps=1.08u w=0.7u l=3u
X152 dynamic_pcell$5_0.G_DRN dynamic_pcell$5_0.G_DRN VDD VDD sg13_lv_pmos ad=0.475p pd=2.88u as=0.475p ps=2.88u w=2.5u l=3u
X153 VDD VDD VDD VDD sg13_lv_pmos ad=95f pd=0.88u as=0 ps=0 w=0.5u l=0.5u
X154 VDD VDD VDD VDD sg13_lv_pmos ad=0.2375p pd=1.63u as=0 ps=0 w=1.25u l=0.5u
X155 VDD VDD VDD VDD sg13_lv_pmos ad=95f pd=0.88u as=0 ps=0 w=0.5u l=0.5u
X156 VSS VSS ota_cmfb_core_push_pull_output_stage_1/dynamic_pcell$4_0.DRN_NET_MENX VSS sg13_lv_nmos ad=0.133p pd=1.08u as=0.133p ps=1.08u w=0.7u l=0.5u
X157 VSS VSS VSS VSS sg13_lv_nmos ad=0.133p pd=1.08u as=0 ps=0 w=0.7u l=0.5u
X158 VDD EN EN_INV_1/sg13cmos5l_inv_4_0.Y VDD sg13_lv_pmos ad=0.3808p pd=2.92u as=0.2128p ps=1.5u w=1.12u l=0.13u
X159 ota_cmfb_core_push_pull_output_stage_0/dynamic_pcell$4_0.DRN_NET_HI ota_cmfb_core_push_pull_output_stage_0/dynamic_pcell$4_0.SRC_NET_IJ_GATE_DI ota_cmfb_core_push_pull_output_stage_0/dynamic_pcell$4_0.SRC_NET_IJ_GATE_DI VDD sg13_lv_pmos ad=0.475p pd=2.88u as=0.85p ps=5.68u w=2.5u l=3u
X160 VSS Ibias dynamic_pcell$5_0.DRN_NET_BD VSS sg13_lv_nmos ad=62.5f pd=0.74u as=62.5f ps=0.74u w=0.25u l=10u
X161 VDD VDD VDD VDD sg13_lv_pmos ad=0.17p pd=1.68u as=0 ps=0 w=0.5u l=0.5u
X162 ota_cmfb_core_push_pull_output_stage_0/dynamic_pcell$4_0.B_DRN dynamic_pcell$5_0.F_DRN VDD VDD sg13_lv_pmos ad=0.475p pd=2.88u as=0.475p ps=2.88u w=2.5u l=3u
X163 VSS Ibias dynamic_pcell$5_0.DRN_NET_CA VSS sg13_lv_nmos ad=62.5f pd=0.74u as=62.5f ps=0.74u w=0.25u l=10u
X164 VSS VSS Ibias VSS sg13_lv_nmos ad=62.5f pd=0.74u as=62.5f ps=0.74u w=0.25u l=0.5u
X165 dynamic_pcell$5_0.DRN_NET_CA Ibias VSS VSS sg13_lv_nmos ad=62.5f pd=0.74u as=62.5f ps=0.74u w=0.25u l=10u
X166 VDD VDD VDD VDD sg13_lv_pmos ad=0.475p pd=2.88u as=0 ps=0 w=2.5u l=0.5u
X167 VDD VDD VDD VDD sg13_lv_pmos ad=0.2375p pd=1.63u as=0 ps=0 w=1.25u l=0.5u
X168 VDD VDD VDD VDD sg13_lv_pmos ad=0.2375p pd=1.63u as=0 ps=0 w=1.25u l=0.5u
X169 dynamic_pcell$5_0.DRN_NET_BD Ibias VSS VSS sg13_lv_nmos ad=62.5f pd=0.74u as=62.5f ps=0.74u w=0.25u l=10u
X170 VDD VDD VDD VDD sg13_lv_pmos ad=95f pd=0.88u as=0 ps=0 w=0.5u l=0.5u
X171 ota_cmfb_core_push_pull_output_stage_0/dynamic_pcell$4_0.DRN_NET_HI dynamic_pcell$5_0.F_DRN VDD VDD sg13_lv_pmos ad=0.475p pd=2.88u as=0.475p ps=2.88u w=2.5u l=3u
X172 EN_INV_0/sg13cmos5l_inv_4_0.Y EN VDD VDD sg13_lv_pmos ad=0.2128p pd=1.5u as=0.2128p ps=1.5u w=1.12u l=0.13u
X173 VDD VDD VDD VDD sg13_lv_pmos ad=0.17p pd=1.68u as=0 ps=0 w=0.5u l=0.5u
X174 VDD VDD VDD VDD sg13_lv_pmos ad=95f pd=0.88u as=0 ps=0 w=0.5u l=0.5u
X175 ota_cmfb_core_push_pull_output_stage_1/dynamic_pcell$4_0.DRN_NET_J_GATE_EJ ota_cmfb_core_push_pull_output_stage_1/dynamic_pcell$4_0.Gate VSS VSS sg13_lv_nmos ad=0.133p pd=1.08u as=0.133p ps=1.08u w=0.7u l=3u
X176 ota_cmfb_core_push_pull_output_stage_0/dynamic_pcell$4_0.DRN_NET_OP_GATE_MP VSS VSS VSS sg13_lv_nmos ad=0.133p pd=1.08u as=0.133p ps=1.08u w=0.7u l=0.5u
X177 VSS VSS VSS VSS sg13_lv_nmos ad=0.133p pd=1.08u as=0 ps=0 w=0.7u l=0.5u
X178 VSS VSS ota_cmfb_core_push_pull_output_stage_1/dynamic_pcell$4_0.DRN_NET_OP_GATE_MP VSS sg13_lv_nmos ad=0.133p pd=1.08u as=0.133p ps=1.08u w=0.7u l=0.5u
X179 VSS VSS VSS VSS sg13_lv_nmos ad=0.133p pd=1.08u as=0 ps=0 w=0.7u l=0.5u
X180 VDD VDD VDD VDD sg13_lv_pmos ad=0.2375p pd=1.63u as=0 ps=0 w=1.25u l=0.5u
X181 VDD VDD VDD VDD sg13_lv_pmos ad=95f pd=0.88u as=0 ps=0 w=0.5u l=0.5u
X182 VSS dynamic_pcell$5_0.Gate dynamic_pcell_0.Gate VSS sg13_lv_nmos ad=62.5f pd=0.74u as=62.5f ps=0.74u w=0.25u l=10u
X183 VDD VDD VDD VDD sg13_lv_pmos ad=0.475p pd=2.88u as=0 ps=0 w=2.5u l=0.5u
X184 VDD VDD VDD VDD sg13_lv_pmos ad=0.475p pd=2.88u as=0 ps=0 w=2.5u l=0.5u
X185 dynamic_pcell$5_0.Gate dynamic_pcell$5_0.Gate VSS VSS sg13_lv_nmos ad=62.5f pd=0.74u as=62.5f ps=0.74u w=0.25u l=10u
X186 VDD VDD VDD VDD sg13_lv_pmos ad=0.2375p pd=1.63u as=0 ps=0 w=1.25u l=0.5u
X187 dynamic_pcell$5_0.G_DRN Ibias VSS VSS sg13_lv_nmos ad=62.5f pd=0.74u as=62.5f ps=0.74u w=0.25u l=10u
X188 VSS VSS dynamic_pcell$6_0.Gate VSS sg13_lv_nmos ad=62.5f pd=0.74u as=62.5f ps=0.74u w=0.25u l=0.5u
X189 VSS VSS VSS VSS sg13_lv_nmos ad=95f pd=0.88u as=0 ps=0 w=0.5u l=0.5u
X190 VDD dynamic_pcell$5_0.G_DRN dynamic_pcell$5_0.G_DRN VDD sg13_lv_pmos ad=0.475p pd=2.88u as=0.85p ps=5.68u w=2.5u l=3u
X191 VSS Ibias dynamic_pcell$5_0.F_DRN VSS sg13_lv_nmos ad=62.5f pd=0.74u as=62.5f ps=0.74u w=0.25u l=10u
X192 Voutp dynamic_pcell$5_0.DRN_NET_BD VDD VDD sg13_lv_pmos ad=95f pd=0.88u as=95f ps=0.88u w=0.5u l=0.5u
X193 VDD dynamic_pcell$5_0.DRN_NET_BD Voutp VDD sg13_lv_pmos ad=95f pd=0.88u as=95f ps=0.88u w=0.5u l=0.5u
X194 a_821_n1629# a_1085_n1915# VSS rhigh l=1u w=0.5u
X195 ota_cmfb_core_push_pull_output_stage_1/dynamic_pcell$4_0.DRN_NET_HI dynamic_pcell$5_0.G_DRN VDD VDD sg13_lv_pmos ad=0.475p pd=2.88u as=0.475p ps=2.88u w=2.5u l=3u
X196 dynamic_pcell$5_0.DRN_NET_CA Vinp dynamic_pcell_0.M_DRN VDD sg13_lv_pmos ad=0.475p pd=2.88u as=0.475p ps=2.88u w=2.5u l=2u
X197 EN_INV_1/sg13cmos5l_inv_4_0.Y EN VSS VSS sg13_lv_nmos ad=0.1406p pd=1.12u as=0.1406p ps=1.12u w=0.74u l=0.13u
X198 a_1085_n2190# a_821_n2476# VSS rhigh l=1u w=0.5u
X199 VDD dynamic_pcell$5_0.DRN_NET_CA Voutn VDD sg13_lv_pmos ad=95f pd=0.88u as=95f ps=0.88u w=0.5u l=0.5u
X200 VDD VDD VDD VDD sg13_lv_pmos ad=0.475p pd=2.88u as=0 ps=0 w=2.5u l=0.5u
X201 ota_cmfb_core_push_pull_output_stage_0/dynamic_pcell$4_0.DRN_NET_MENX VSS VSS VSS sg13_lv_nmos ad=0.133p pd=1.08u as=0.133p ps=1.08u w=0.7u l=0.5u
X202 VDD dynamic_pcell$6_0.Gate dynamic_pcell$6_0.DRN_NET_O VDD sg13_lv_pmos ad=0.2375p pd=1.63u as=0.2375p ps=1.63u w=1.25u l=5u
X203 VSS VSS ota_cmfb_core_push_pull_output_stage_1/dynamic_pcell$4_0.SRC_NET_ML VSS sg13_lv_nmos ad=0.133p pd=1.08u as=0.133p ps=1.08u w=0.7u l=0.5u
X204 a_9091_4309# a_9355_4023# VSS rhigh l=1u w=0.5u
X205 VSS VSS VSS VSS sg13_lv_nmos ad=0.133p pd=1.08u as=0 ps=0 w=0.7u l=0.5u
X206 VDD dynamic_pcell$5_0.DRN_NET_CA Voutn VDD sg13_lv_pmos ad=95f pd=0.88u as=95f ps=0.88u w=0.5u l=0.5u
X207 a_821_n1629# a_557_n1915# VSS rhigh l=1u w=0.5u
X208 dynamic_pcell$6_0.DRN_NET_O VDD VDD VDD sg13_lv_pmos ad=0.475p pd=2.88u as=0.475p ps=2.88u w=2.5u l=0.5u
X209 a_557_n2190# a_821_n2476# VSS rhigh l=1u w=0.5u
X210 VDD VDD VDD VDD sg13_lv_pmos ad=0.475p pd=2.88u as=0 ps=0 w=2.5u l=0.5u
X211 VDD VDD VDD VDD sg13_lv_pmos ad=0.475p pd=2.88u as=0 ps=0 w=2.5u l=0.5u
X212 VSS EN EN_INV_0/sg13cmos5l_inv_4_0.Y VSS sg13_lv_nmos ad=0.1406p pd=1.12u as=0.1406p ps=1.12u w=0.74u l=0.13u
X213 ota_cmfb_core_push_pull_output_stage_0/dynamic_pcell$4_0.DRN_NET_MENX ota_cmfb_core_push_pull_output_stage_0/dynamic_pcell$4_0.DRN_NET_OP_GATE_MP ota_cmfb_core_push_pull_output_stage_0/dynamic_pcell$4_0.SRC_NET_ML VSS sg13_lv_nmos ad=0.133p pd=1.08u as=0.133p ps=1.08u w=0.7u l=3u
X214 VSS ota_cmfb_core_push_pull_output_stage_1/dynamic_pcell$4_0.DRN_NET_MENX Voutn VSS sg13_lv_nmos ad=0.17p pd=1.68u as=0.17p ps=1.68u w=0.5u l=10u
X215 VDD VDD VDD VDD sg13_lv_pmos ad=0.475p pd=2.88u as=0 ps=0 w=2.5u l=0.5u
X216 dynamic_pcell$5_0.Gate VCM dynamic_pcell$6_0.DRN_NET_O VDD sg13_lv_pmos ad=0.85p pd=5.68u as=0.475p ps=2.88u w=2.5u l=2u
X217 Ibias Ibias VSS VSS sg13_lv_nmos ad=62.5f pd=0.74u as=62.5f ps=0.74u w=0.25u l=10u
X218 VDD VDD dynamic_pcell$5_0.DRN_NET_CA VDD sg13_lv_pmos ad=0.475p pd=2.88u as=0.475p ps=2.88u w=2.5u l=0.5u
X219 VSS Ibias dynamic_pcell$6_0.Gate VSS sg13_lv_nmos ad=62.5f pd=0.74u as=62.5f ps=0.74u w=0.25u l=10u
X220 VDD VDD VDD VDD sg13_lv_pmos ad=95f pd=0.88u as=0 ps=0 w=0.5u l=0.5u
X221 ota_cmfb_core_push_pull_output_stage_1/dynamic_pcell$4_0.SRC_NET_ML VSS VSS VSS sg13_lv_nmos ad=0.133p pd=1.08u as=0.133p ps=1.08u w=0.7u l=0.5u
X222 VSS VSS VSS VSS sg13_lv_nmos ad=95f pd=0.88u as=0 ps=0 w=0.5u l=0.5u
X223 dynamic_pcell_0.M_DRN Vinp dynamic_pcell$5_0.DRN_NET_CA VDD sg13_lv_pmos ad=0.475p pd=2.88u as=0.475p ps=2.88u w=2.5u l=2u
X224 ota_cmfb_core_push_pull_output_stage_0/dynamic_pcell$4_0.DRN_NET_CD dynamic_pcell$5_0.F_DRN VDD VDD sg13_lv_pmos ad=0.475p pd=2.88u as=0.475p ps=2.88u w=2.5u l=3u
X225 dynamic_pcell$5_0.DRN_NET_CA ota_cmfb_core_push_pull_output_stage_1/dynamic_pcell$4_0.DRN_NET_J_GATE_EJ ota_cmfb_core_push_pull_output_stage_1/dynamic_pcell$4_0.DRN_NET_MENX VDD sg13_lv_pmos ad=0.85p pd=5.68u as=0.475p ps=2.88u w=2.5u l=3u
X226 VSS VSS VSS VSS sg13_lv_nmos ad=95f pd=0.88u as=0 ps=0 w=0.5u l=0.5u
X227 a_2094_4832# a_2358_4546# VSS rhigh l=1u w=0.5u
X228 VDD VDD VDD VDD sg13_lv_pmos ad=95f pd=0.88u as=0 ps=0 w=0.5u l=0.5u
X229 VSS VSS VSS VSS sg13_lv_nmos ad=95f pd=0.88u as=0 ps=0 w=0.5u l=0.5u
X230 VSS VSS VSS VSS sg13_lv_nmos ad=95f pd=0.88u as=0 ps=0 w=0.5u l=0.5u
X231 VDD VDD VDD VDD sg13_lv_pmos ad=0.2375p pd=1.63u as=0 ps=0 w=1.25u l=0.5u
X232 ota_cmfb_core_push_pull_output_stage_0/dynamic_pcell$4_0.DRN_NET_OP_GATE_MP VSS VSS VSS sg13_lv_nmos ad=0.133p pd=1.08u as=0.133p ps=1.08u w=0.7u l=0.5u
X233 dynamic_pcell_0.M_DRN dynamic_pcell_0.Gate VDD VDD sg13_lv_pmos ad=0.475p pd=2.88u as=0.475p ps=2.88u w=2.5u l=10u
X234 VSS VSS VSS VSS sg13_lv_nmos ad=0.133p pd=1.08u as=0 ps=0 w=0.7u l=0.5u
X235 VSS VSS VSS VSS sg13_lv_nmos ad=0.133p pd=1.08u as=0 ps=0 w=0.7u l=0.5u
X236 VDD VDD VDD VDD sg13_lv_pmos ad=95f pd=0.88u as=0 ps=0 w=0.5u l=0.5u
X237 VDD VDD VDD VDD sg13_lv_pmos ad=0.2375p pd=1.63u as=0 ps=0 w=1.25u l=0.5u
X238 VDD VDD VDD VDD sg13_lv_pmos ad=0.475p pd=2.88u as=0 ps=0 w=2.5u l=0.5u
X239 VDD VDD VDD VDD sg13_lv_pmos ad=0.85p pd=5.68u as=0 ps=0 w=2.5u l=0.5u
X240 VDD VDD VDD VDD sg13_lv_pmos ad=0.2375p pd=1.63u as=0 ps=0 w=1.25u l=0.5u
X241 dynamic_pcell$6_0.Gate Ibias VSS VSS sg13_lv_nmos ad=62.5f pd=0.74u as=62.5f ps=0.74u w=0.25u l=10u
X242 dynamic_pcell$5_0.DRN_NET_BD Vinn dynamic_pcell_0.M_DRN VDD sg13_lv_pmos ad=0.475p pd=2.88u as=0.475p ps=2.88u w=2.5u l=2u
X243 VDD VDD VDD VDD sg13_lv_pmos ad=95f pd=0.88u as=0 ps=0 w=0.5u l=0.5u
X244 VSS Ibias Ibias VSS sg13_lv_nmos ad=62.5f pd=0.74u as=62.5f ps=0.74u w=0.25u l=10u
X245 VDD VDD VDD VDD sg13_lv_pmos ad=0.475p pd=2.88u as=0 ps=0 w=2.5u l=0.5u
X246 dynamic_pcell$6_0.DRN_NET_O dynamic_pcell$6_0.Gate VDD VDD sg13_lv_pmos ad=0.2375p pd=1.63u as=0.2375p ps=1.63u w=1.25u l=5u
X247 dynamic_pcell_0.M_DRN VDD VDD VDD sg13_lv_pmos ad=0.475p pd=2.88u as=0.475p ps=2.88u w=2.5u l=0.5u
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
