YacineSot/sg13cmos5l_yacinesot_ip__diff_opamp_cmfb/scripts/output/slot_5__ota_cmfb_top/magic_RC/ota_cmfb_top.pex.spice

* NGSPICE file created from ota_cmfb_top.ext - technology: ihp-sg13g2

.subckt ota_cmfb_top VDD VSS Ibias EN Vinp Vinn VCM Voutp Voutn
X0 a_2358_4309# a_2622_4023# VSS.t17 rhigh l=1u w=0.5u
X1 dynamic_pcell_0.M_DRN Vinn dynamic_pcell$5_0.DRN_NET_BD VDD sg13_lv_pmos ad=0.85p pd=5.68u as=0.475p ps=2.88u w=2.5u l=2u
X2 VDD VDD VDD VDD sg13_lv_pmos ad=0.85p pd=5.68u as=1.01479n ps=3.4011m w=2.5u l=0.5u
X3 dynamic_pcell$5_0.DRN_NET_CA ota_cmfb_core_push_pull_output_stage_1/dynamic_pcell$4_0.SRC_NET_IJ_GATE_DI ota_cmfb_core_push_pull_output_stage_1/dynamic_pcell$4_0.DRN_NET_CD VDD sg13_lv_pmos ad=0.475p pd=2.88u as=0.85p ps=5.68u w=2.5u l=3u
X4 a_2094_4832# a_2094_4309# VSS.t372 rhigh l=1u w=0.5u
X5 VDD VDD VDD VDD sg13_lv_pmos ad=0.475p pd=2.88u as=0 ps=0 w=2.5u l=0.5u
X6 VSS.t34 ota_cmfb_core_push_pull_output_stage_0/dynamic_pcell$4_0.DRN_NET_MENX Voutp VSS.t33 sg13_lv_nmos ad=0.17p pd=1.68u as=0.17p ps=1.68u w=0.5u l=10u
X7 dynamic_pcell$5_0.DRN_NET_E_GATE_CDEFGH.t5 EN Ibias VSS.t351 sg13_lv_nmos ad=0.2516p pd=2.16u as=0.2516p ps=2.16u w=0.74u l=0.13u
X8 dynamic_pcell$5_0.F_DRN.t0 VDD VDD VDD sg13_lv_pmos ad=0.475p pd=2.88u as=0.475p ps=2.88u w=2.5u l=0.5u
X9 VDD VDD VDD VDD sg13_lv_pmos ad=0.2375p pd=1.63u as=0 ps=0 w=1.25u l=0.5u
X10 ota_cmfb_core_push_pull_output_stage_1/dynamic_pcell$4_0.SRC_NET_ML ota_cmfb_core_push_pull_output_stage_1/dynamic_pcell$4_0.DRN_NET_OP_GATE_MP ota_cmfb_core_push_pull_output_stage_1/dynamic_pcell$4_0.DRN_NET_MENX VSS.t28 sg13_lv_nmos ad=0.133p pd=1.08u as=0.133p ps=1.08u w=0.7u l=3u
X11 EN_INV_1/sg13cmos5l_inv_4_0.Y EN VSS.t344 VSS.t342 sg13_lv_nmos ad=0.1406p pd=1.12u as=0.1406p ps=1.12u w=0.74u l=0.13u
X12 VDD dynamic_pcell$6_0.Gate dynamic_pcell$6_0.DRN_NET_O.t2 VDD sg13_lv_pmos ad=0.2375p pd=1.63u as=0.2375p ps=1.63u w=1.25u l=5u
X13 VDD VDD VDD VDD sg13_lv_pmos ad=0.475p pd=2.88u as=0 ps=0 w=2.5u l=0.5u
X14 VSS.t175 VSS.t173 VSS.t174 VSS.t136 sg13_lv_nmos ad=0.238p pd=2.08u as=0 ps=0 w=0.7u l=0.5u
X15 ota_cmfb_core_push_pull_output_stage_1/dynamic_pcell$4_0.SRC_NET_ML ota_cmfb_core_push_pull_output_stage_1/dynamic_pcell$4_0.DRN_NET_OP_GATE_MP ota_cmfb_core_push_pull_output_stage_1/dynamic_pcell$4_0.DRN_NET_MENX VSS.t32 sg13_lv_nmos ad=0.133p pd=1.08u as=0.133p ps=1.08u w=0.7u l=3u
X16 VDD VDD VDD VDD sg13_lv_pmos ad=0.85p pd=5.68u as=0 ps=0 w=2.5u l=0.5u
X17 VDD dynamic_pcell$5_0.G_DRN dynamic_pcell$5_0.G_DRN.t5 VDD sg13_lv_pmos ad=0.475p pd=2.88u as=0.475p ps=2.88u w=2.5u l=3u
X18 ota_cmfb_core_push_pull_output_stage_1/dynamic_pcell$4_0.Gate ota_cmfb_core_push_pull_output_stage_1/dynamic_pcell$4_0.DRN_NET_OP_GATE_MP ota_cmfb_core_push_pull_output_stage_1/dynamic_pcell$4_0.DRN_NET_OP_GATE_MP VSS.t29 sg13_lv_nmos ad=0.133p pd=1.08u as=0.133p ps=1.08u w=0.7u l=3u
X19 a_9355_4832# w_9940_4004# VSS.t39 rhigh l=1u w=0.5u
X20 dynamic_pcell$6_0.DRN_NET_O.t5 dynamic_pcell$6_0.Gate VDD VDD sg13_lv_pmos ad=0.2375p pd=1.63u as=0.2375p ps=1.63u w=1.25u l=5u
X21 VSS.t95 VSS.t94 dynamic_pcell$5_0.F_DRN.t1 VSS.t61 sg13_lv_nmos ad=62.5f pd=0.74u as=62.5f ps=0.74u w=0.25u l=0.5u
X22 dynamic_pcell$5_0.DRN_NET_E_GATE_CDEFGH.t4 EN_INV_1/sg13cmos5l_inv_4_0.Y VSS.t316 VSS.t315 sg13_lv_nmos ad=0.2516p pd=2.16u as=0.2516p ps=2.16u w=0.74u l=0.13u
X23 ota_cmfb_core_push_pull_output_stage_1/dynamic_pcell$4_0.B_DRN ota_cmfb_core_push_pull_output_stage_1/dynamic_pcell$4_0.B_DRN ota_cmfb_core_push_pull_output_stage_1/dynamic_pcell$4_0.DRN_NET_OP_GATE_MP VSS.t27 sg13_lv_nmos ad=0.133p pd=1.08u as=0.133p ps=1.08u w=0.7u l=3u
X24 dynamic_pcell$5_0.DRN_NET_CA ota_cmfb_core_push_pull_output_stage_1/dynamic_pcell$4_0.DRN_NET_J_GATE_EJ ota_cmfb_core_push_pull_output_stage_1/dynamic_pcell$4_0.DRN_NET_MENX VDD sg13_lv_pmos ad=0.475p pd=2.88u as=0.85p ps=5.68u w=2.5u l=3u
X25 VDD dynamic_pcell$5_0.G_DRN dynamic_pcell$5_0.G_DRN.t8 VDD sg13_lv_pmos ad=0.85p pd=5.68u as=0.475p ps=2.88u w=2.5u l=3u
X26 VDD VDD VDD VDD sg13_lv_pmos ad=0.2375p pd=1.63u as=0 ps=0 w=1.25u l=0.5u
X27 VSS.t34 VSS.t290 VSS.t34 VSS.t298 sg13_lv_nmos ad=95f pd=0.88u as=0 ps=0 w=0.5u l=0.5u
X28 VSS.t26 dynamic_pcell$5_0.DRN_NET_E_GATE_CDEFGH dynamic_pcell$5_0.DRN_NET_BD VSS.t10 sg13_lv_nmos ad=62.5f pd=0.74u as=62.5f ps=0.74u w=0.25u l=10u
X29 ota_cmfb_core_push_pull_output_stage_1/dynamic_pcell$4_0.DRN_NET_HI ota_cmfb_core_push_pull_output_stage_1/dynamic_pcell$4_0.SRC_NET_IJ_GATE_DI ota_cmfb_core_push_pull_output_stage_1/dynamic_pcell$4_0.SRC_NET_IJ_GATE_DI VDD sg13_lv_pmos ad=0.475p pd=2.88u as=0.85p ps=5.68u w=2.5u l=3u
X30 VDD dynamic_pcell$5_0.DRN_NET_CA Voutn VDD sg13_lv_pmos ad=95f pd=0.88u as=95f ps=0.88u w=0.5u l=0.5u
X31 VDD dynamic_pcell$5_0.F_DRN ota_cmfb_core_push_pull_output_stage_0/dynamic_pcell$4_0.B_DRN VDD sg13_lv_pmos ad=0.85p pd=5.68u as=0.475p ps=2.88u w=2.5u l=3u
X32 dynamic_pcell$5_0.DRN_NET_E_GATE_CDEFGH.t1 VSS.t101 VSS.t99 VSS.t68 sg13_lv_nmos ad=62.5f pd=0.74u as=62.5f ps=0.74u w=0.25u l=0.5u
X33 ota_cmfb_core_push_pull_output_stage_1/dynamic_pcell$4_0.B_DRN dynamic_pcell$5_0.G_DRN VDD VDD sg13_lv_pmos ad=0.475p pd=2.88u as=0.85p ps=5.68u w=2.5u l=3u
X34 ota_cmfb_core_push_pull_output_stage_1/dynamic_pcell$4_0.DRN_NET_CD ota_cmfb_core_push_pull_output_stage_1/dynamic_pcell$4_0.SRC_NET_IJ_GATE_DI dynamic_pcell$5_0.DRN_NET_CA VDD sg13_lv_pmos ad=0.85p pd=5.68u as=0.475p ps=2.88u w=2.5u l=3u
X35 ota_cmfb_core_push_pull_output_stage_1/dynamic_pcell$4_0.DRN_NET_HI dynamic_pcell$5_0.G_DRN VDD VDD sg13_lv_pmos ad=0.475p pd=2.88u as=0.85p ps=5.68u w=2.5u l=3u
X36 ota_cmfb_core_push_pull_output_stage_1/dynamic_pcell$4_0.SRC_NET_IJ_GATE_DI ota_cmfb_core_push_pull_output_stage_1/dynamic_pcell$4_0.SRC_NET_IJ_GATE_DI ota_cmfb_core_push_pull_output_stage_1/dynamic_pcell$4_0.DRN_NET_HI VDD sg13_lv_pmos ad=0.85p pd=5.68u as=0.475p ps=2.88u w=2.5u l=3u
X37 ota_cmfb_core_push_pull_output_stage_1/dynamic_pcell$4_0.Gate ota_cmfb_core_push_pull_output_stage_1/dynamic_pcell$4_0.DRN_NET_OP_GATE_MP ota_cmfb_core_push_pull_output_stage_1/dynamic_pcell$4_0.DRN_NET_OP_GATE_MP VSS.t31 sg13_lv_nmos ad=0.133p pd=1.08u as=0.133p ps=1.08u w=0.7u l=3u
X38 dynamic_pcell$5_0.DRN_NET_BD Vinn dynamic_pcell_0.M_DRN VDD sg13_lv_pmos ad=0.475p pd=2.88u as=0.475p ps=2.88u w=2.5u l=2u
X39 Voutn dynamic_pcell$5_0.DRN_NET_CA VDD VDD sg13_lv_pmos ad=95f pd=0.88u as=95f ps=0.88u w=0.5u l=0.5u
X40 VDD VDD VDD VDD sg13_lv_pmos ad=0.475p pd=2.88u as=0 ps=0 w=2.5u l=0.5u
X41 VSS.t340 EN dantenna l=0.78u w=1.56u
X42 VDD VDD dynamic_pcell$5_0.Gate VDD sg13_lv_pmos ad=0.475p pd=2.88u as=0.475p ps=2.88u w=2.5u l=0.5u
X43 VSS.t157 VSS.t155 VSS.t156 VSS.t136 sg13_lv_nmos ad=0.238p pd=2.08u as=0 ps=0 w=0.7u l=0.5u
X44 VDD VDD ota_cmfb_core_push_pull_output_stage_0/dynamic_pcell$4_0.SRC_NET_IJ_GATE_DI VDD sg13_lv_pmos ad=0.475p pd=2.88u as=0.475p ps=2.88u w=2.5u l=0.5u
X45 VDD VDD VDD VDD sg13_lv_pmos ad=0.85p pd=5.68u as=0 ps=0 w=2.5u l=0.5u
X46 VDD VDD VDD VDD sg13_lv_pmos ad=0.85p pd=5.68u as=0 ps=0 w=2.5u l=0.5u
X47 VSS.t302 ota_cmfb_core_push_pull_output_stage_1/dynamic_pcell$4_0.Gate ota_cmfb_core_push_pull_output_stage_1/dynamic_pcell$4_0.SRC_NET_ML VSS.t29 sg13_lv_nmos ad=0.133p pd=1.08u as=0.133p ps=1.08u w=0.7u l=3u
X48 VDD VDD VDD VDD sg13_lv_pmos ad=0.85p pd=5.68u as=0 ps=0 w=2.5u l=0.5u
X49 VSS.t189 VSS.t188 ota_cmfb_core_push_pull_output_stage_1/dynamic_pcell$4_0.SRC_NET_ML VSS.t58 sg13_lv_nmos ad=0.133p pd=1.08u as=0.133p ps=1.08u w=0.7u l=0.5u
X50 VDD VDD VDD VDD sg13_lv_pmos ad=95f pd=0.88u as=0 ps=0 w=0.5u l=0.5u
X51 ota_cmfb_core_push_pull_output_stage_1/dynamic_pcell$4_0.DRN_NET_MENX ota_cmfb_core_push_pull_output_stage_1/dynamic_pcell$4_0.DRN_NET_OP_GATE_MP ota_cmfb_core_push_pull_output_stage_1/dynamic_pcell$4_0.SRC_NET_ML VSS.t27 sg13_lv_nmos ad=0.133p pd=1.08u as=0.133p ps=1.08u w=0.7u l=3u
X52 VSS.t26 dynamic_pcell$5_0.DRN_NET_E_GATE_CDEFGH dynamic_pcell$5_0.DRN_NET_BD VSS.t10 sg13_lv_nmos ad=62.5f pd=0.74u as=62.5f ps=0.74u w=0.25u l=10u
X53 dynamic_pcell$5_0.Gate EN_INV_0/sg13cmos5l_inv_4_0.Y VSS.t335 VSS.t315 sg13_lv_nmos ad=0.2516p pd=2.16u as=0.2516p ps=2.16u w=0.74u l=0.13u
X54 VDD VDD VDD VDD sg13_lv_pmos ad=0.2375p pd=1.63u as=0 ps=0 w=1.25u l=0.5u
X55 VSS.t279 VSS.t277 VSS.t279 VSS.t278 sg13_lv_nmos ad=0.17p pd=1.68u as=0 ps=0 w=0.5u l=0.5u
X56 VSS.t16 VSS.t131 VSS.t16 VSS.t61 sg13_lv_nmos ad=62.5f pd=0.74u as=0 ps=0 w=0.25u l=0.5u
X57 VDD EN dynamic_pcell$6_0.Gate.t6 VDD sg13_lv_pmos ad=0.1005p pd=1.34u as=0.1005p ps=1.34u w=0.15u l=0.13u
X58 VDD VDD VDD VDD sg13_lv_pmos ad=0.475p pd=2.88u as=0 ps=0 w=2.5u l=0.5u
X59 VDD VDD VDD VDD sg13_lv_pmos ad=0.475p pd=2.88u as=0 ps=0 w=2.5u l=0.5u
X60 dynamic_pcell$5_0.DRN_NET_CA ota_cmfb_core_push_pull_output_stage_1/dynamic_pcell$4_0.B_DRN ota_cmfb_core_push_pull_output_stage_1/dynamic_pcell$4_0.DRN_NET_MENX VSS.t31 sg13_lv_nmos ad=0.133p pd=1.08u as=0.133p ps=1.08u w=0.7u l=3u
X61 VSS.t265 VSS.t265 VSS.t265 VSS.t269 sg13_lv_nmos ad=95f pd=0.88u as=0 ps=0 w=0.5u l=0.5u
X62 dynamic_pcell$6_0.Gate.t1 VDD VDD VDD sg13_lv_pmos ad=0.2375p pd=1.63u as=0.2375p ps=1.63u w=1.25u l=0.5u
X63 dynamic_pcell$5_0.G_DRN.t8 dynamic_pcell$5_0.G_DRN VDD VDD sg13_lv_pmos ad=0.475p pd=2.88u as=0.475p ps=2.88u w=2.5u l=3u
X64 VDD VDD ota_cmfb_core_push_pull_output_stage_1/dynamic_pcell$4_0.DRN_NET_CD VDD sg13_lv_pmos ad=0.475p pd=2.88u as=0.475p ps=2.88u w=2.5u l=0.5u
X65 dynamic_pcell$5_0.DRN_NET_BD EN VDD VDD sg13_lv_pmos ad=0.1005p pd=1.34u as=0.1005p ps=1.34u w=0.15u l=0.13u
X66 VSS.t149 VSS.t147 VSS.t148 VSS.t136 sg13_lv_nmos ad=0.238p pd=2.08u as=0 ps=0 w=0.7u l=0.5u
X67 VDD VDD VDD VDD sg13_lv_pmos ad=0.425p pd=3.18u as=0 ps=0 w=1.25u l=0.5u
X68 dynamic_pcell_0.M_DRN dynamic_pcell_0.Gate VDD VDD sg13_lv_pmos ad=0.475p pd=2.88u as=0.475p ps=2.88u w=2.5u l=10u
X69 ota_cmfb_core_push_pull_output_stage_1/dynamic_pcell$4_0.DRN_NET_OP_GATE_MP ota_cmfb_core_push_pull_output_stage_1/dynamic_pcell$4_0.B_DRN ota_cmfb_core_push_pull_output_stage_1/dynamic_pcell$4_0.B_DRN VSS.t32 sg13_lv_nmos ad=0.133p pd=1.08u as=0.133p ps=1.08u w=0.7u l=3u
X70 VDD VDD dynamic_pcell_0.M_DRN VDD sg13_lv_pmos ad=0.475p pd=2.88u as=0.475p ps=2.88u w=2.5u l=0.5u
X71 VSS.t34 VSS.t290 VSS.t34 VSS.t294 sg13_lv_nmos ad=95f pd=0.88u as=0 ps=0 w=0.5u l=0.5u
X72 VSS.t189 VSS.t198 VSS.t199 VSS.t140 sg13_lv_nmos ad=0.133p pd=1.08u as=0 ps=0 w=0.7u l=0.5u
X73 dynamic_pcell$5_0.F_DRN.t1 dynamic_pcell$5_0.DRN_NET_E_GATE_CDEFGH.t10 VSS.t26 VSS.t11 sg13_lv_nmos ad=62.5f pd=0.74u as=62.5f ps=0.74u w=0.25u l=10u
X74 a_n235_n1629# a_29_n1915# VSS.t3 rhigh l=1u w=0.5u
X75 VDD VDD VDD VDD sg13_lv_pmos ad=0.85p pd=5.68u as=0 ps=0 w=2.5u l=0.5u
X76 VSS.t79 VSS.t78 VSS.t79 VSS.t61 sg13_lv_nmos ad=62.5f pd=0.74u as=0 ps=0 w=0.25u l=0.5u
X77 VDD VDD VDD VDD sg13_lv_pmos ad=95f pd=0.88u as=0 ps=0 w=0.5u l=0.5u
X78 VSS.t26 dynamic_pcell$5_0.DRN_NET_E_GATE_CDEFGH.t11 dynamic_pcell$5_0.G_DRN.t10 VSS.t6 sg13_lv_nmos ad=62.5f pd=0.74u as=62.5f ps=0.74u w=0.25u l=10u
X79 a_29_n2190# a_n235_n2476# VSS.t369 rhigh l=1u w=0.5u
X80 VDD EN ota_cmfb_core_push_pull_output_stage_1/EN_INV_0/sg13cmos5l_inv_4_0.Y VDD sg13_lv_pmos ad=0.3808p pd=2.92u as=0.2128p ps=1.5u w=1.12u l=0.13u
X81 VSS.t123 VSS.t121 VSS.t122 VSS.t61 sg13_lv_nmos ad=62.5f pd=0.74u as=0 ps=0 w=0.25u l=0.5u
X82 VDD VDD VDD VDD sg13_lv_pmos ad=0.475p pd=2.88u as=0 ps=0 w=2.5u l=0.5u
X83 a_8827_4832# a_9091_4546# VSS.t4 rhigh l=1u w=0.5u
X84 dynamic_pcell_0.M_DRN dynamic_pcell_0.Gate VDD VDD sg13_lv_pmos ad=0.475p pd=2.88u as=0.475p ps=2.88u w=2.5u l=10u
X85 ota_cmfb_core_push_pull_output_stage_1/dynamic_pcell$4_0.Gate ota_cmfb_core_push_pull_output_stage_1/dynamic_pcell$4_0.Gate VSS.t302 VSS.t31 sg13_lv_nmos ad=0.133p pd=1.08u as=0.133p ps=1.08u w=0.7u l=3u
X86 dynamic_pcell_0.M_DRN Vinn dynamic_pcell$5_0.DRN_NET_BD VDD sg13_lv_pmos ad=0.475p pd=2.88u as=0.475p ps=2.88u w=2.5u l=2u
X87 VSS.t253 VSS.t253 VSS.t253 VSS.t259 sg13_lv_nmos ad=95f pd=0.88u as=0 ps=0 w=0.5u l=0.5u
X88 VSS.t253 VSS.t253 VSS.t253 VSS.t263 sg13_lv_nmos ad=95f pd=0.88u as=0 ps=0 w=0.5u l=0.5u
X89 dynamic_pcell_0.Gate.t4 dynamic_pcell$5_0.L_GATE dynamic_pcell$6_0.DRN_NET_O.t1 VDD sg13_lv_pmos ad=0.85p pd=5.68u as=0.475p ps=2.88u w=2.5u l=2u
X90 Voutp dynamic_pcell$5_0.DRN_NET_BD VDD VDD sg13_lv_pmos ad=95f pd=0.88u as=95f ps=0.88u w=0.5u l=0.5u
X91 ota_cmfb_core_push_pull_output_stage_1/dynamic_pcell$4_0.DRN_NET_CD dynamic_pcell$5_0.G_DRN VDD VDD sg13_lv_pmos ad=0.475p pd=2.88u as=0.475p ps=2.88u w=2.5u l=3u
X92 a_1349_n1629# Voutp VSS.t35 rhigh l=1u w=0.5u
X93 EN_INV_0/sg13cmos5l_inv_4_0.Y EN VDD VDD sg13_lv_pmos ad=0.2128p pd=1.5u as=0.3808p ps=2.92u w=1.12u l=0.13u
X94 VDD VDD dynamic_pcell$6_0.Gate.t0 VDD sg13_lv_pmos ad=0.2375p pd=1.63u as=0.2375p ps=1.63u w=1.25u l=0.5u
X95 a_2622_4832# a_2358_4546# VSS.t17 rhigh l=1u w=0.5u
X96 VDD VDD VDD VDD sg13_lv_pmos ad=0.85p pd=5.68u as=0 ps=0 w=2.5u l=0.5u
X97 ota_cmfb_core_push_pull_output_stage_1/dynamic_pcell$4_0.SRC_NET_IJ_GATE_DI ota_cmfb_core_push_pull_output_stage_1/dynamic_pcell$4_0.DRN_NET_J_GATE_EJ ota_cmfb_core_push_pull_output_stage_1/dynamic_pcell$4_0.DRN_NET_J_GATE_EJ VDD sg13_lv_pmos ad=0.475p pd=2.88u as=0.475p ps=2.88u w=2.5u l=3u
X98 VSS.t138 VSS.t135 VSS.t137 VSS.t136 sg13_lv_nmos ad=0.238p pd=2.08u as=0 ps=0 w=0.7u l=0.5u
X99 Voutn a_1349_n2476# VSS.t365 rhigh l=1u w=0.5u
X100 dynamic_pcell$6_0.Gate.t0 dynamic_pcell$6_0.Gate.t4 VDD VDD sg13_lv_pmos ad=0.2375p pd=1.63u as=0.2375p ps=1.63u w=1.25u l=5u
X101 VDD dynamic_pcell_0.Gate dynamic_pcell_0.M_DRN VDD sg13_lv_pmos ad=0.475p pd=2.88u as=0.475p ps=2.88u w=2.5u l=10u
X102 ota_cmfb_core_push_pull_output_stage_1/dynamic_pcell$4_0.DRN_NET_MENX VSS.t160 VSS.t161 VSS.t32 sg13_lv_nmos ad=0.133p pd=1.08u as=0.133p ps=1.08u w=0.7u l=3u
X103 Voutn dynamic_pcell$5_0.DRN_NET_CA VDD VDD sg13_lv_pmos ad=95f pd=0.88u as=95f ps=0.88u w=0.5u l=0.5u
X104 ota_cmfb_core_push_pull_output_stage_0/dynamic_pcell$4_0.SRC_NET_ML VSS.t248 VSS.t246 VSS.t191 sg13_lv_nmos ad=0.133p pd=1.08u as=0.133p ps=1.08u w=0.7u l=0.5u
X105 ota_cmfb_core_push_pull_output_stage_0/dynamic_pcell$4_0.DRN_NET_CD ota_cmfb_core_push_pull_output_stage_0/dynamic_pcell$4_0.SRC_NET_IJ_GATE_DI dynamic_pcell$5_0.DRN_NET_BD VDD sg13_lv_pmos ad=0.475p pd=2.88u as=0.475p ps=2.88u w=2.5u l=3u
X106 VDD VDD ota_cmfb_core_push_pull_output_stage_1/dynamic_pcell$4_0.SRC_NET_IJ_GATE_DI VDD sg13_lv_pmos ad=0.475p pd=2.88u as=0.475p ps=2.88u w=2.5u l=0.5u
X107 VSS.t179 VSS.t178 ota_cmfb_core_push_pull_output_stage_1/dynamic_pcell$4_0.DRN_NET_OP_GATE_MP VSS.t58 sg13_lv_nmos ad=0.133p pd=1.08u as=0.133p ps=1.08u w=0.7u l=0.5u
X108 VSS.t12 VSS.t69 VSS.t12 VSS.t61 sg13_lv_nmos ad=62.5f pd=0.74u as=0 ps=0 w=0.25u l=0.5u
X109 a_293_n1629# a_557_n1915# VSS.t35 rhigh l=1u w=0.5u
X110 Voutn dynamic_pcell$5_0.DRN_NET_CA VDD VDD sg13_lv_pmos ad=95f pd=0.88u as=95f ps=0.88u w=0.5u l=0.5u
X111 ota_cmfb_core_push_pull_output_stage_1/dynamic_pcell$4_0.DRN_NET_CD ota_cmfb_core_push_pull_output_stage_1/dynamic_pcell$4_0.SRC_NET_IJ_GATE_DI dynamic_pcell$5_0.DRN_NET_CA VDD sg13_lv_pmos ad=0.475p pd=2.88u as=0.475p ps=2.88u w=2.5u l=3u
X112 a_557_n2190# a_293_n2476# VSS.t36 rhigh l=1u w=0.5u
X113 VDD dynamic_pcell$5_0.G_DRN ota_cmfb_core_push_pull_output_stage_1/dynamic_pcell$4_0.DRN_NET_CD VDD sg13_lv_pmos ad=0.475p pd=2.88u as=0.475p ps=2.88u w=2.5u l=3u
X114 VSS.t113 VSS.t112 dynamic_pcell$5_0.G_DRN.t11 VSS.t61 sg13_lv_nmos ad=62.5f pd=0.74u as=62.5f ps=0.74u w=0.25u l=0.5u
X115 VSS.t265 VSS.t265 VSS.t265 VSS.t266 sg13_lv_nmos ad=0.17p pd=1.68u as=0 ps=0 w=0.5u l=0.5u
X116 VSS.t16 dynamic_pcell$5_0.Gate dynamic_pcell$5_0.Gate VSS.t11 sg13_lv_nmos ad=62.5f pd=0.74u as=62.5f ps=0.74u w=0.25u l=10u
X117 dynamic_pcell$5_0.DRN_NET_BD Vinn dynamic_pcell_0.M_DRN VDD sg13_lv_pmos ad=0.475p pd=2.88u as=0.475p ps=2.88u w=2.5u l=2u
X118 VSS.t302 ota_cmfb_core_push_pull_output_stage_1/dynamic_pcell$4_0.Gate ota_cmfb_core_push_pull_output_stage_1/dynamic_pcell$4_0.DRN_NET_J_GATE_EJ VSS.t31 sg13_lv_nmos ad=0.133p pd=1.08u as=0.133p ps=1.08u w=0.7u l=3u
X119 dynamic_pcell_0.Gate.t1 dynamic_pcell$5_0.Gate VSS.t13 VSS.t6 sg13_lv_nmos ad=62.5f pd=0.74u as=62.5f ps=0.74u w=0.25u l=10u
X120 dynamic_pcell_0.Gate.t2 dynamic_pcell$5_0.L_GATE dynamic_pcell$6_0.DRN_NET_O.t7 VDD sg13_lv_pmos ad=0.475p pd=2.88u as=0.85p ps=5.68u w=2.5u l=2u
X121 VDD EN ota_cmfb_core_push_pull_output_stage_0/EN_INV_0/sg13cmos5l_inv_4_0.Y VDD sg13_lv_pmos ad=0.2128p pd=1.5u as=0.2128p ps=1.5u w=1.12u l=0.13u
X122 VDD VDD VDD VDD sg13_lv_pmos ad=95f pd=0.88u as=0 ps=0 w=0.5u l=0.5u
X123 ota_cmfb_core_push_pull_output_stage_1/dynamic_pcell$4_0.DRN_NET_MENX VDD VDD VDD sg13_lv_pmos ad=0.475p pd=2.88u as=0.475p ps=2.88u w=2.5u l=0.5u
X124 dynamic_pcell$5_0.G_DRN.t6 dynamic_pcell$5_0.G_DRN VDD VDD sg13_lv_pmos ad=0.475p pd=2.88u as=0.475p ps=2.88u w=2.5u l=3u
X125 VSS.t302 ota_cmfb_core_push_pull_output_stage_1/dynamic_pcell$4_0.Gate ota_cmfb_core_push_pull_output_stage_1/dynamic_pcell$4_0.Gate VSS.t32 sg13_lv_nmos ad=0.133p pd=1.08u as=0.133p ps=1.08u w=0.7u l=3u
X126 VDD VDD VDD VDD sg13_lv_pmos ad=95f pd=0.88u as=0 ps=0 w=0.5u l=0.5u
X127 ota_cmfb_core_push_pull_output_stage_1/EN_INV_0/sg13cmos5l_inv_4_0.Y EN VSS.t353 VSS.t352 sg13_lv_nmos ad=0.1406p pd=1.12u as=0.2516p ps=2.16u w=0.74u l=0.13u
X128 VDD VDD VDD VDD sg13_lv_pmos ad=0.2375p pd=1.63u as=0 ps=0 w=1.25u l=0.5u
X129 VDD VDD VDD VDD sg13_lv_pmos ad=95f pd=0.88u as=0 ps=0 w=0.5u l=0.5u
X130 VSS.t169 VSS.t171 ota_cmfb_core_push_pull_output_stage_1/dynamic_pcell$4_0.DRN_NET_MENX VSS.t58 sg13_lv_nmos ad=0.133p pd=1.08u as=0.133p ps=1.08u w=0.7u l=0.5u
X131 VSS.t182 VSS.t180 VSS.t179 VSS.t140 sg13_lv_nmos ad=0.133p pd=1.08u as=0 ps=0 w=0.7u l=0.5u
X132 VDD EN EN_INV_0/sg13cmos5l_inv_4_0.Y VDD sg13_lv_pmos ad=0.3808p pd=2.92u as=0.2128p ps=1.5u w=1.12u l=0.13u
X133 VDD VDD VDD VDD sg13_lv_pmos ad=0.17p pd=1.68u as=0 ps=0 w=0.5u l=0.5u
X134 ota_cmfb_core_push_pull_output_stage_0/dynamic_pcell$4_0.DRN_NET_HI ota_cmfb_core_push_pull_output_stage_0/dynamic_pcell$4_0.SRC_NET_IJ_GATE_DI ota_cmfb_core_push_pull_output_stage_0/dynamic_pcell$4_0.SRC_NET_IJ_GATE_DI VDD sg13_lv_pmos ad=0.475p pd=2.88u as=0.85p ps=5.68u w=2.5u l=3u
X135 VSS.t79 dynamic_pcell$5_0.DRN_NET_E_GATE_CDEFGH dynamic_pcell$5_0.DRN_NET_BD VSS.t11 sg13_lv_nmos ad=62.5f pd=0.74u as=62.5f ps=0.74u w=0.25u l=10u
X136 ota_cmfb_core_push_pull_output_stage_0/dynamic_pcell$4_0.B_DRN dynamic_pcell$5_0.F_DRN VDD VDD sg13_lv_pmos ad=0.475p pd=2.88u as=0.475p ps=2.88u w=2.5u l=3u
X137 dynamic_pcell$5_0.DRN_NET_CA dynamic_pcell$5_0.DRN_NET_E_GATE_CDEFGH VSS.t77 VSS.t6 sg13_lv_nmos ad=62.5f pd=0.74u as=62.5f ps=0.74u w=0.25u l=10u
X138 VSS.t123 dynamic_pcell$5_0.DRN_NET_E_GATE_CDEFGH dynamic_pcell$5_0.DRN_NET_CA VSS.t11 sg13_lv_nmos ad=62.5f pd=0.74u as=62.5f ps=0.74u w=0.25u l=10u
X139 VSS.t62 VSS.t60 dynamic_pcell$5_0.DRN_NET_E_GATE_CDEFGH.t3 VSS.t61 sg13_lv_nmos ad=62.5f pd=0.74u as=62.5f ps=0.74u w=0.25u l=0.5u
X140 VDD VDD VDD VDD sg13_lv_pmos ad=0.475p pd=2.88u as=0 ps=0 w=2.5u l=0.5u
X141 VDD VDD VDD VDD sg13_lv_pmos ad=0.2375p pd=1.63u as=0 ps=0 w=1.25u l=0.5u
X142 VDD VDD VDD VDD sg13_lv_pmos ad=0.2375p pd=1.63u as=0 ps=0 w=1.25u l=0.5u
X143 dynamic_pcell$5_0.DRN_NET_BD dynamic_pcell$5_0.DRN_NET_E_GATE_CDEFGH VSS.t13 VSS.t6 sg13_lv_nmos ad=62.5f pd=0.74u as=62.5f ps=0.74u w=0.25u l=10u
X144 a_n763_n1629# dynamic_pcell$5_0.L_GATE VSS.t37 rhigh l=1u w=0.5u
X145 VDD VDD VDD VDD sg13_lv_pmos ad=95f pd=0.88u as=0 ps=0 w=0.5u l=0.5u
X146 dynamic_pcell$5_0.L_GATE a_n763_n2476# VSS.t2 rhigh l=1u w=0.5u
X147 ota_cmfb_core_push_pull_output_stage_0/dynamic_pcell$4_0.DRN_NET_HI dynamic_pcell$5_0.F_DRN VDD VDD sg13_lv_pmos ad=0.475p pd=2.88u as=0.475p ps=2.88u w=2.5u l=3u
X148 EN_INV_1/sg13cmos5l_inv_4_0.Y EN VDD VDD sg13_lv_pmos ad=0.2128p pd=1.5u as=0.2128p ps=1.5u w=1.12u l=0.13u
X149 VDD VDD VDD VDD sg13_lv_pmos ad=0.17p pd=1.68u as=0 ps=0 w=0.5u l=0.5u
X150 VDD VDD VDD VDD sg13_lv_pmos ad=95f pd=0.88u as=0 ps=0 w=0.5u l=0.5u
X151 ota_cmfb_core_push_pull_output_stage_1/dynamic_pcell$4_0.DRN_NET_J_GATE_EJ ota_cmfb_core_push_pull_output_stage_1/dynamic_pcell$4_0.Gate VSS.t302 VSS.t32 sg13_lv_nmos ad=0.133p pd=1.08u as=0.133p ps=1.08u w=0.7u l=3u
X152 ota_cmfb_core_push_pull_output_stage_0/dynamic_pcell$4_0.DRN_NET_OP_GATE_MP VSS.t230 VSS.t231 VSS.t191 sg13_lv_nmos ad=0.133p pd=1.08u as=0.133p ps=1.08u w=0.7u l=0.5u
X153 VSS.t252 VSS.t250 VSS.t235 VSS.t207 sg13_lv_nmos ad=0.133p pd=1.08u as=0 ps=0 w=0.7u l=0.5u
X154 VSS.t59 VSS.t57 ota_cmfb_core_push_pull_output_stage_1/dynamic_pcell$4_0.DRN_NET_OP_GATE_MP VSS.t58 sg13_lv_nmos ad=0.133p pd=1.08u as=0.133p ps=1.08u w=0.7u l=0.5u
X155 VSS.t170 VSS.t168 VSS.t169 VSS.t140 sg13_lv_nmos ad=0.133p pd=1.08u as=0 ps=0 w=0.7u l=0.5u
X156 ota_cmfb_core_push_pull_output_stage_0/dynamic_pcell$4_0.Gate ota_cmfb_core_push_pull_output_stage_0/EN_INV_0/sg13cmos5l_inv_4_0.Y VSS.t368 VSS.t367 sg13_lv_nmos ad=0.2516p pd=2.16u as=0.2516p ps=2.16u w=0.74u l=0.13u
X157 VDD VDD VDD VDD sg13_lv_pmos ad=95f pd=0.88u as=0 ps=0 w=0.5u l=0.5u
X158 VDD VDD VDD VDD sg13_lv_pmos ad=0.2375p pd=1.63u as=0 ps=0 w=1.25u l=0.5u
X159 ota_cmfb_core_push_pull_output_stage_0/EN_INV_0/sg13cmos5l_inv_4_0.Y EN VSS.t361 VSS.t362 sg13_lv_nmos ad=0.1406p pd=1.12u as=0.1406p ps=1.12u w=0.74u l=0.13u
X160 VSS.t12 dynamic_pcell$5_0.Gate dynamic_pcell_0.Gate.t0 VSS.t11 sg13_lv_nmos ad=62.5f pd=0.74u as=62.5f ps=0.74u w=0.25u l=10u
X161 VSS.t355 EN ota_cmfb_core_push_pull_output_stage_1/EN_INV_0/sg13cmos5l_inv_4_0.Y VSS.t354 sg13_lv_nmos ad=0.1406p pd=1.12u as=0.1406p ps=1.12u w=0.74u l=0.13u
X162 VDD VDD VDD VDD sg13_lv_pmos ad=0.475p pd=2.88u as=0 ps=0 w=2.5u l=0.5u
X163 VDD VDD VDD VDD sg13_lv_pmos ad=0.2375p pd=1.63u as=0 ps=0 w=1.25u l=0.5u
X164 VSS.t88 VSS.t92 dynamic_pcell$6_0.Gate.t2 VSS.t61 sg13_lv_nmos ad=62.5f pd=0.74u as=62.5f ps=0.74u w=0.25u l=0.5u
X165 VDD VDD VDD VDD sg13_lv_pmos ad=0.475p pd=2.88u as=0 ps=0 w=2.5u l=0.5u
X166 dynamic_pcell$5_0.Gate dynamic_pcell$5_0.Gate VSS.t7 VSS.t6 sg13_lv_nmos ad=62.5f pd=0.74u as=62.5f ps=0.74u w=0.25u l=10u
X167 dynamic_pcell$5_0.G_DRN.t11 dynamic_pcell$5_0.DRN_NET_E_GATE_CDEFGH.t6 VSS.t26 VSS.t11 sg13_lv_nmos ad=62.5f pd=0.74u as=62.5f ps=0.74u w=0.25u l=10u
X168 VSS.t34 VSS.t290 VSS.t34 VSS.t296 sg13_lv_nmos ad=95f pd=0.88u as=0 ps=0 w=0.5u l=0.5u
X169 VDD dynamic_pcell$5_0.G_DRN dynamic_pcell$5_0.G_DRN.t0 VDD sg13_lv_pmos ad=0.475p pd=2.88u as=0.85p ps=5.68u w=2.5u l=3u
X170 VSS.t26 dynamic_pcell$5_0.DRN_NET_E_GATE_CDEFGH.t7 dynamic_pcell$5_0.F_DRN.t2 VSS.t6 sg13_lv_nmos ad=62.5f pd=0.74u as=62.5f ps=0.74u w=0.25u l=10u
X171 VDD dynamic_pcell$5_0.DRN_NET_BD Voutp VDD sg13_lv_pmos ad=95f pd=0.88u as=95f ps=0.88u w=0.5u l=0.5u
X172 ota_cmfb_core_push_pull_output_stage_1/dynamic_pcell$4_0.DRN_NET_HI dynamic_pcell$5_0.G_DRN VDD VDD sg13_lv_pmos ad=0.475p pd=2.88u as=0.475p ps=2.88u w=2.5u l=3u
X173 Voutp dynamic_pcell$5_0.DRN_NET_BD VDD VDD sg13_lv_pmos ad=95f pd=0.88u as=95f ps=0.88u w=0.5u l=0.5u
X174 a_2358_4309# a_2094_4023# VSS.t337 rhigh l=1u w=0.5u
X175 dynamic_pcell$5_0.DRN_NET_CA Vinp dynamic_pcell_0.M_DRN VDD sg13_lv_pmos ad=0.475p pd=2.88u as=0.475p ps=2.88u w=2.5u l=2u
X176 EN_INV_0/sg13cmos5l_inv_4_0.Y EN VSS.t343 VSS.t342 sg13_lv_nmos ad=0.1406p pd=1.12u as=0.1406p ps=1.12u w=0.74u l=0.13u
X177 VDD dynamic_pcell$5_0.DRN_NET_CA Voutn VDD sg13_lv_pmos ad=95f pd=0.88u as=95f ps=0.88u w=0.5u l=0.5u
X178 ota_cmfb_core_push_pull_output_stage_0/dynamic_pcell$4_0.DRN_NET_MENX VSS.t190 VSS.t192 VSS.t191 sg13_lv_nmos ad=0.133p pd=1.08u as=0.133p ps=1.08u w=0.7u l=0.5u
X179 VDD VDD VDD VDD sg13_lv_pmos ad=0.475p pd=2.88u as=0 ps=0 w=2.5u l=0.5u
X180 VDD dynamic_pcell$6_0.Gate dynamic_pcell$6_0.DRN_NET_O.t4 VDD sg13_lv_pmos ad=0.2375p pd=1.63u as=0.2375p ps=1.63u w=1.25u l=5u
X181 VSS.t141 VSS.t145 ota_cmfb_core_push_pull_output_stage_1/dynamic_pcell$4_0.SRC_NET_ML VSS.t58 sg13_lv_nmos ad=0.133p pd=1.08u as=0.133p ps=1.08u w=0.7u l=0.5u
X182 VDD dynamic_pcell$5_0.DRN_NET_CA Voutn VDD sg13_lv_pmos ad=95f pd=0.88u as=95f ps=0.88u w=0.5u l=0.5u
X183 VSS.t154 VSS.t152 VSS.t59 VSS.t140 sg13_lv_nmos ad=0.133p pd=1.08u as=0 ps=0 w=0.7u l=0.5u
X184 dynamic_pcell$6_0.DRN_NET_O.t1 VDD VDD VDD sg13_lv_pmos ad=0.475p pd=2.88u as=0.475p ps=2.88u w=2.5u l=0.5u
X185 VDD VDD VDD VDD sg13_lv_pmos ad=0.475p pd=2.88u as=0 ps=0 w=2.5u l=0.5u
X186 VDD VDD VDD VDD sg13_lv_pmos ad=0.475p pd=2.88u as=0 ps=0 w=2.5u l=0.5u
X187 ota_cmfb_core_push_pull_output_stage_0/dynamic_pcell$4_0.DRN_NET_MENX ota_cmfb_core_push_pull_output_stage_0/dynamic_pcell$4_0.DRN_NET_OP_GATE_MP ota_cmfb_core_push_pull_output_stage_0/dynamic_pcell$4_0.SRC_NET_ML VSS.t23 sg13_lv_nmos ad=0.133p pd=1.08u as=0.133p ps=1.08u w=0.7u l=3u
X188 VSS.t344 EN EN_INV_1/sg13cmos5l_inv_4_0.Y VSS.t342 sg13_lv_nmos ad=0.1406p pd=1.12u as=0.1406p ps=1.12u w=0.74u l=0.13u
X189 VSS.t265 ota_cmfb_core_push_pull_output_stage_1/dynamic_pcell$4_0.DRN_NET_MENX Voutn VSS.t371 sg13_lv_nmos ad=0.17p pd=1.68u as=0.17p ps=1.68u w=0.5u l=10u
X190 dynamic_pcell$5_0.DRN_NET_E_GATE_CDEFGH.t3 dynamic_pcell$5_0.DRN_NET_E_GATE_CDEFGH.t2 VSS.t26 VSS.t11 sg13_lv_nmos ad=62.5f pd=0.74u as=62.5f ps=0.74u w=0.25u l=10u
X191 VDD VDD VDD VDD sg13_lv_pmos ad=0.475p pd=2.88u as=0 ps=0 w=2.5u l=0.5u
X192 dynamic_pcell$5_0.Gate VCM dynamic_pcell$6_0.DRN_NET_O.t0 VDD sg13_lv_pmos ad=0.85p pd=5.68u as=0.475p ps=2.88u w=2.5u l=2u
X193 VDD VDD dynamic_pcell$5_0.DRN_NET_CA VDD sg13_lv_pmos ad=0.475p pd=2.88u as=0.475p ps=2.88u w=2.5u l=0.5u
X194 VSS.t26 dynamic_pcell$5_0.DRN_NET_E_GATE_CDEFGH.t8 dynamic_pcell$6_0.Gate.t3 VSS.t6 sg13_lv_nmos ad=62.5f pd=0.74u as=62.5f ps=0.74u w=0.25u l=10u
X195 ota_cmfb_core_push_pull_output_stage_1/dynamic_pcell$4_0.SRC_NET_ML VSS.t186 VSS.t184 VSS.t144 sg13_lv_nmos ad=0.133p pd=1.08u as=0.133p ps=1.08u w=0.7u l=0.5u
X196 VDD VDD VDD VDD sg13_lv_pmos ad=95f pd=0.88u as=0 ps=0 w=0.5u l=0.5u
X197 dynamic_pcell_0.M_DRN Vinp dynamic_pcell$5_0.DRN_NET_CA VDD sg13_lv_pmos ad=0.475p pd=2.88u as=0.475p ps=2.88u w=2.5u l=2u
X198 VSS.t279 VSS.t277 VSS.t279 VSS.t286 sg13_lv_nmos ad=95f pd=0.88u as=0 ps=0 w=0.5u l=0.5u
X199 dynamic_pcell$5_0.DRN_NET_CA ota_cmfb_core_push_pull_output_stage_1/dynamic_pcell$4_0.DRN_NET_J_GATE_EJ ota_cmfb_core_push_pull_output_stage_1/dynamic_pcell$4_0.DRN_NET_MENX VDD sg13_lv_pmos ad=0.85p pd=5.68u as=0.475p ps=2.88u w=2.5u l=3u
X200 VSS.t279 VSS.t277 VSS.t279 VSS.t282 sg13_lv_nmos ad=95f pd=0.88u as=0 ps=0 w=0.5u l=0.5u
X201 ota_cmfb_core_push_pull_output_stage_0/dynamic_pcell$4_0.DRN_NET_CD dynamic_pcell$5_0.F_DRN VDD VDD sg13_lv_pmos ad=0.475p pd=2.88u as=0.475p ps=2.88u w=2.5u l=3u
X202 VDD VDD VDD VDD sg13_lv_pmos ad=95f pd=0.88u as=0 ps=0 w=0.5u l=0.5u
X203 VSS.t253 VSS.t253 VSS.t253 VSS.t255 sg13_lv_nmos ad=95f pd=0.88u as=0 ps=0 w=0.5u l=0.5u
X204 VDD VDD VDD VDD sg13_lv_pmos ad=0.2375p pd=1.63u as=0 ps=0 w=1.25u l=0.5u
X205 VSS.t265 VSS.t265 VSS.t265 VSS.t273 sg13_lv_nmos ad=95f pd=0.88u as=0 ps=0 w=0.5u l=0.5u
X206 ota_cmfb_core_push_pull_output_stage_0/dynamic_pcell$4_0.DRN_NET_OP_GATE_MP VSS.t212 VSS.t210 VSS.t191 sg13_lv_nmos ad=0.133p pd=1.08u as=0.133p ps=1.08u w=0.7u l=0.5u
X207 dynamic_pcell_0.M_DRN dynamic_pcell_0.Gate VDD VDD sg13_lv_pmos ad=0.475p pd=2.88u as=0.475p ps=2.88u w=2.5u l=10u
X208 VSS.t244 VSS.t242 VSS.t233 VSS.t207 sg13_lv_nmos ad=0.133p pd=1.08u as=0 ps=0 w=0.7u l=0.5u
X209 VDD VDD VDD VDD sg13_lv_pmos ad=95f pd=0.88u as=0 ps=0 w=0.5u l=0.5u
X210 VSS.t142 VSS.t139 VSS.t141 VSS.t140 sg13_lv_nmos ad=0.133p pd=1.08u as=0 ps=0 w=0.7u l=0.5u
X211 VDD VDD VDD VDD sg13_lv_pmos ad=0.2375p pd=1.63u as=0 ps=0 w=1.25u l=0.5u
X212 VDD VDD VDD VDD sg13_lv_pmos ad=0.475p pd=2.88u as=0 ps=0 w=2.5u l=0.5u
X213 VDD VDD VDD VDD sg13_lv_pmos ad=0.85p pd=5.68u as=0 ps=0 w=2.5u l=0.5u
X214 dynamic_pcell$5_0.F_DRN.t13 EN VDD VDD sg13_lv_pmos ad=0.1005p pd=1.34u as=0.1005p ps=1.34u w=0.15u l=0.13u
X215 VDD VDD VDD VDD sg13_lv_pmos ad=0.2375p pd=1.63u as=0 ps=0 w=1.25u l=0.5u
X216 dynamic_pcell$6_0.Gate.t2 dynamic_pcell$5_0.DRN_NET_E_GATE_CDEFGH.t9 VSS.t26 VSS.t11 sg13_lv_nmos ad=62.5f pd=0.74u as=62.5f ps=0.74u w=0.25u l=10u
X217 dynamic_pcell$5_0.DRN_NET_BD Vinn dynamic_pcell_0.M_DRN VDD sg13_lv_pmos ad=0.475p pd=2.88u as=0.475p ps=2.88u w=2.5u l=2u
X218 VDD VDD VDD VDD sg13_lv_pmos ad=95f pd=0.88u as=0 ps=0 w=0.5u l=0.5u
X219 VDD VDD VDD VDD sg13_lv_pmos ad=0.475p pd=2.88u as=0 ps=0 w=2.5u l=0.5u
X220 VSS.t26 dynamic_pcell$5_0.DRN_NET_E_GATE_CDEFGH.t0 dynamic_pcell$5_0.DRN_NET_E_GATE_CDEFGH.t1 VSS.t6 sg13_lv_nmos ad=62.5f pd=0.74u as=62.5f ps=0.74u w=0.25u l=10u
X221 dynamic_pcell$6_0.DRN_NET_O.t2 dynamic_pcell$6_0.Gate VDD VDD sg13_lv_pmos ad=0.2375p pd=1.63u as=0.2375p ps=1.63u w=1.25u l=5u
X222 dynamic_pcell_0.M_DRN VDD VDD VDD sg13_lv_pmos ad=0.475p pd=2.88u as=0.475p ps=2.88u w=2.5u l=0.5u
X223 VDD VDD VDD VDD sg13_lv_pmos ad=95f pd=0.88u as=0 ps=0 w=0.5u l=0.5u
X224 dynamic_pcell_0.M_DRN Vinp dynamic_pcell$5_0.DRN_NET_CA VDD sg13_lv_pmos ad=0.475p pd=2.88u as=0.475p ps=2.88u w=2.5u l=2u
X225 ota_cmfb_core_push_pull_output_stage_0/dynamic_pcell$4_0.SRC_NET_ML VSS.t204 VSS.t202 VSS.t191 sg13_lv_nmos ad=0.133p pd=1.08u as=0.133p ps=1.08u w=0.7u l=0.5u
X226 a_821_n1629# a_1085_n1915# VSS.t35 rhigh l=1u w=0.5u
X227 VSS.t238 VSS.t236 VSS.t229 VSS.t207 sg13_lv_nmos ad=0.133p pd=1.08u as=0 ps=0 w=0.7u l=0.5u
X228 a_1085_n2190# a_821_n2476# VSS.t314 rhigh l=1u w=0.5u
X229 VSS.t247 VSS.t245 VSS.t246 VSS.t201 sg13_lv_nmos ad=0.238p pd=2.08u as=0 ps=0 w=0.7u l=0.5u
X230 VDD dynamic_pcell$5_0.F_DRN ota_cmfb_core_push_pull_output_stage_0/dynamic_pcell$4_0.DRN_NET_CD VDD sg13_lv_pmos ad=0.475p pd=2.88u as=0.475p ps=2.88u w=2.5u l=3u
X231 a_9091_4309# a_9355_4023# VSS.t336 rhigh l=1u w=0.5u
X232 ota_cmfb_core_push_pull_output_stage_0/dynamic_pcell$4_0.B_DRN ota_cmfb_core_push_pull_output_stage_0/dynamic_pcell$4_0.B_DRN ota_cmfb_core_push_pull_output_stage_0/dynamic_pcell$4_0.DRN_NET_OP_GATE_MP VSS.t23 sg13_lv_nmos ad=0.133p pd=1.08u as=0.133p ps=1.08u w=0.7u l=3u
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
