YacineSot/sg13cmos5l_yacinesot_ip__diff_opamp_cmfb/(commit log)

2026-08-31 Latest schematics
    [ac_probe.sch, ota_cmfb_cm_sense.sch, ota_cmfb_core.sch, ota_cmfb_core_output_stage.sch, ota_cmfb_core_output_stage_tb.sch, ota_cmfb_core_push_pull_output_stage.sch, ota_cmfb_core_push_pull_output_stage_tb.sch, ota_cmfb_core_tb.sch]
2026-09-01 update buffer, stability
    [ac_probe.sch, ota_cmfb_core.sch, ota_cmfb_core_push_pull_output_stage.sch, ota_cmfb_core_push_pull_output_stage_tb.sch, ota_cmfb_tb.sch]
2026-09-03 last updates
    [ota_cmfb_core.sch, ota_cmfb_core_push_pull_output_stage.sch, ota_cmfb_core_push_pull_output_stage_tb.sch, ota_cmfb_tb.sch]
2026-09-03 adding xschemrc to fix absolute paths
    [ota_cmfb_tb.sch]
2026-09-03 updating the readme file + dc simulation
    [ota_cmfb_tb.sch]
2026-09-27 update, final.gds + post layout pex simulation
    [ac_diff_probe.sch, ota_cmfb_cm_sense_tb.sch, ota_cmfb_core.sch, ota_cmfb_core_output_stage_tb.sch, ota_cmfb_core_push_pull_output_stage.sch, ota_cmfb_core_push_pull_output_stage_tb.sch, ota_cmfb_core_tb.sch, ota_cmfb_fbota.sch]
2026-09-27 lvs results
    [ota_cmfb_top.sch]
2026-09-28 wrapper and renaming
    [ota_cmfb_top_pex_tb.sch]
2026-09-28 placing the wrapper + simulations
    [ota_cmfb_top.sch, ota_cmfb_top_pex_tb.sch, ota_cmfb_top_pex_tb_mc_results.csv, ota_cmfb_top_tb.sch, ota_cmfb_top_tb_mc_results.csv]
2026-09-28 fixing some parasitics updating postlayout sim
    [ota_cmfb_top_pex_tb.sch, ota_cmfb_top_pex_tb_mc_results.csv]
2026-10-02 update README+ENABLE COMMAND
    [ota_cmfb_core.sch, ota_cmfb_core_push_pull_output_stage.sch, ota_cmfb_fbota.sch, ota_cmfb_top.sch, ota_cmfb_top_tb.sch, ota_cmfb_top_tb_mc_results.csv]
2026-10-03 final results
    [ota_cmfb_core_push_pull_output_stage.sch, ota_cmfb_top_tb.sch]
2026-10-25 updating wrapper & including clamping diodes
